ftobler/bldc-controller/README.md

# A bunch of BLDC controller and related PCB

Software for STM32.

PCB in Eagle.
