ftobler/bldc-controller/pcb/pcb-bldc-high-current/pcb-bldc-high-current.pdf

GND ⁺³V³ | +5V | VCC | +3V³
GND | GND | GND | GND ⁺⁵V | +5V | +3V³ ¹⁰⁰n

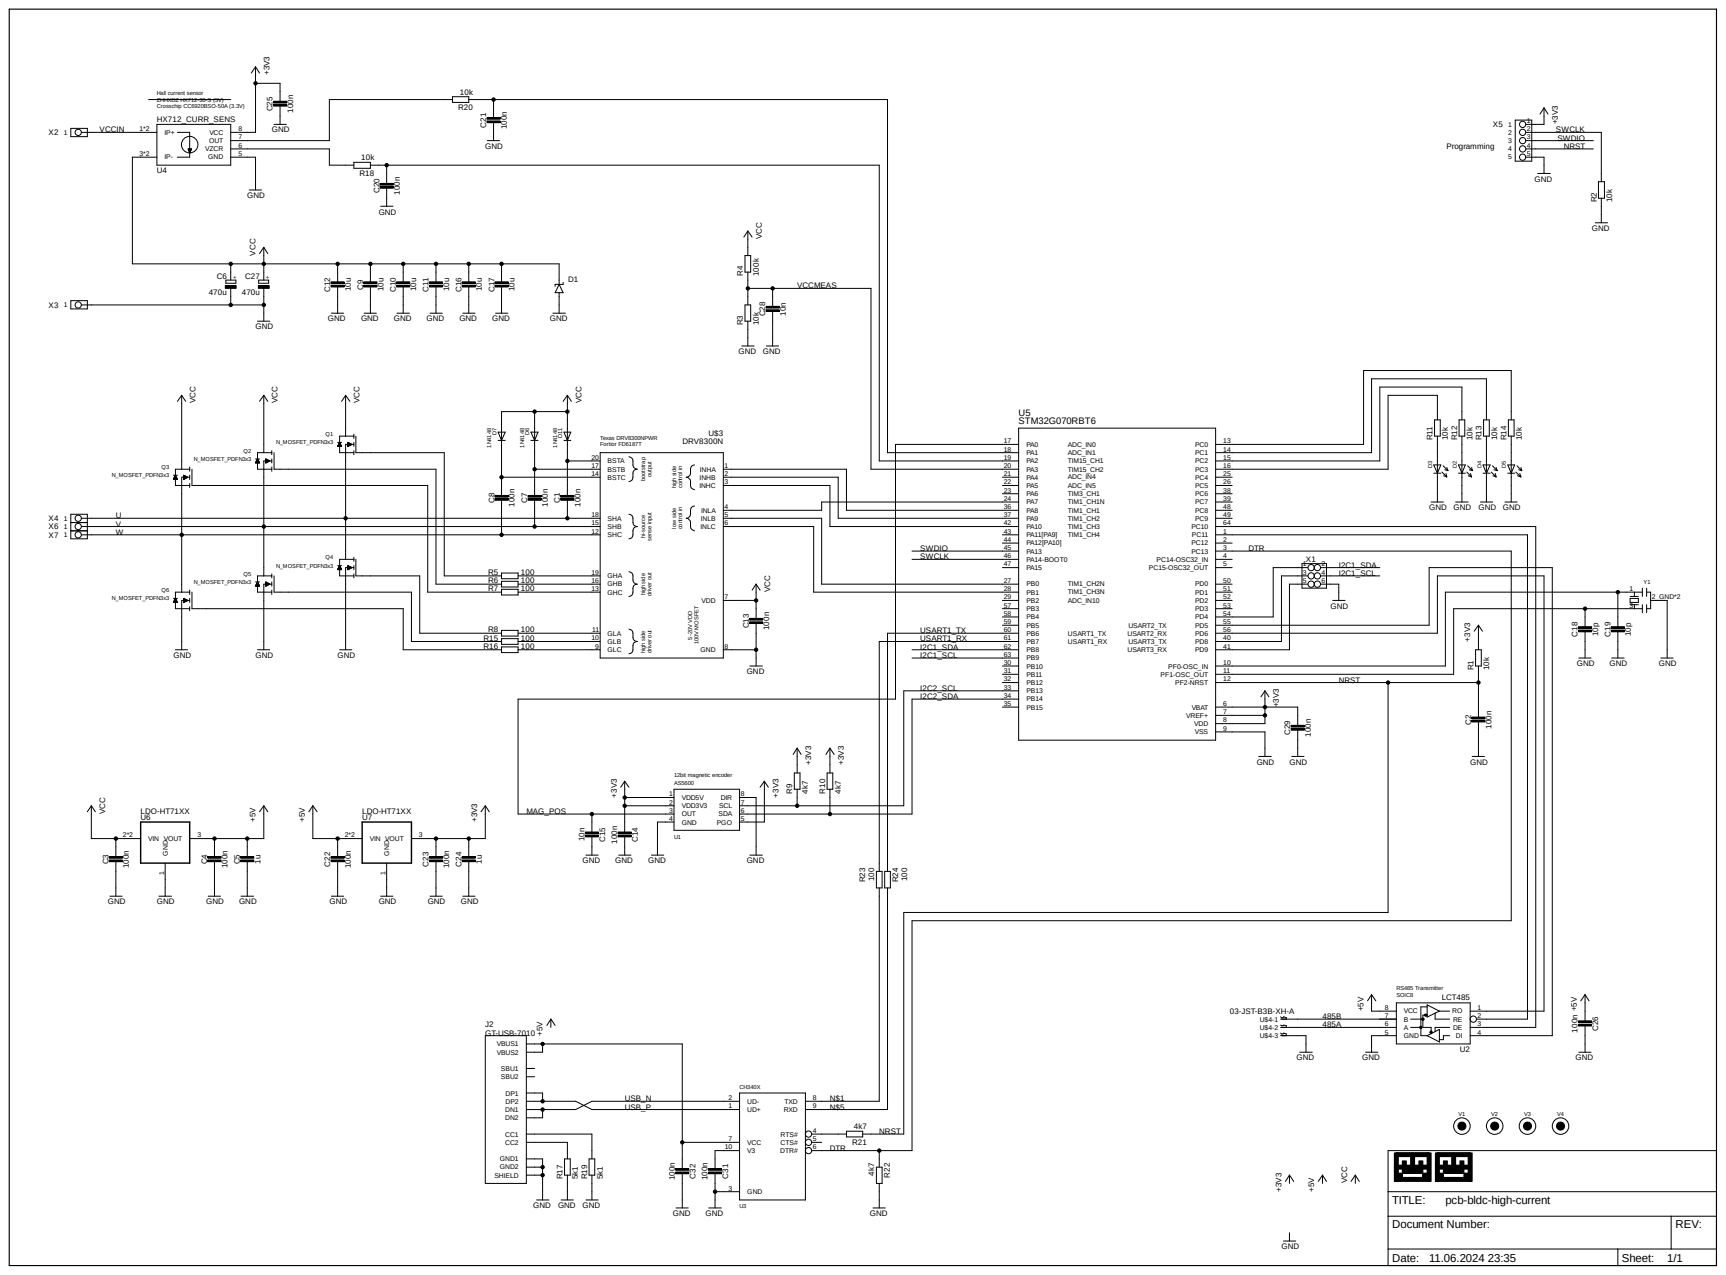
[picture p1: page 1]

GND ¹⁰⁰n GND ⁺³V³

pcb-bldc-high-current

Document Number: | REV:

Date: 11.06.2024 23:35 | Sheet: 1/1
