ftobler/bldc-controller/pcb/pcb-bldc-sensorless2/pcb-bldc-sensorless2.pdf

U2

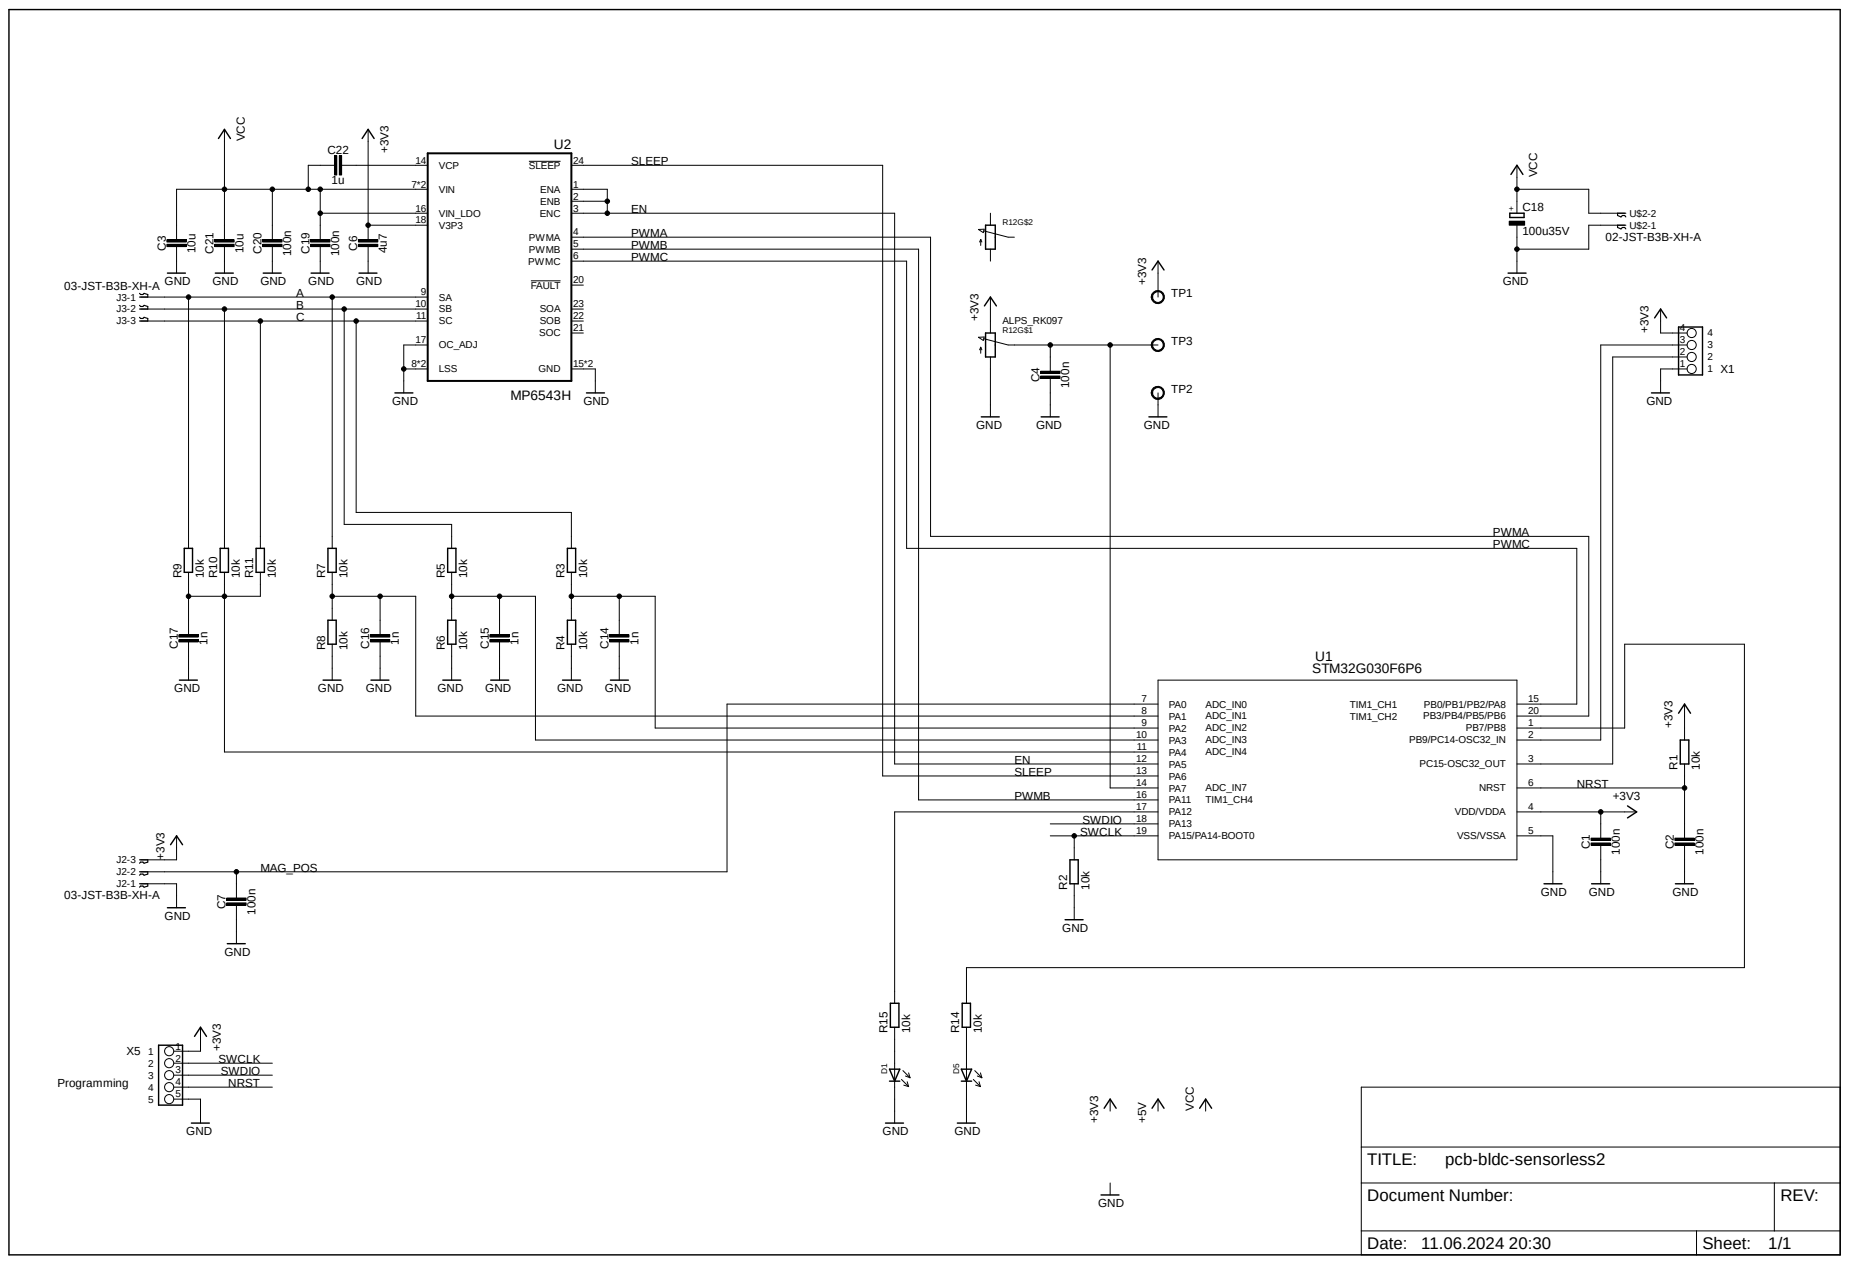
[picture p2: page 1]
GND ⁺³V³; VCC; STM32G030F6P6; GND; GND +3V³; 03-JST-B3B-XH-A ⁺³V³ GND; GND GND; GND ¹⁰k; GND¹⁰k; MP6543H GND; 03-JST-B3B-XH-A; GND ¹⁰u; +3V³ GND; PA6 13 PA7 14 PA11 16 PA12 17 PA13 18 PA15/PA14-BOOT0 19; PB9/PC14-OSC32_IN; PC15-OSC32_OUT; NRST; VDD/VDDA; VSS/VSSA; C¹⁴ R⁵ R⁶; C¹⁵ R⁷ R⁸; C¹⁶ R⁹; R¹⁰; R¹¹ C¹⁷; R¹⁵; R¹⁴; SLEEP; ENA; ENB; ENC; PWMA; PWMB; PWMC; FAULT; SOA; SOB; SOC; VCP 14; VIN 7*2; VIN_LDO 16 V3P3 18; LSS 8*2; OC_ADJ 17; C²¹; C²⁰; C¹⁹; SWDIO; SWCLK; MAG_POS; TITLE: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

02-JST-B3B-XH-A VCC

Document Number: | REV:

Date: 11.06.2024 20:30 | Sheet: 1/1
