ftobler/bldc-controller/pcb/pcb-bldc-high-current/pcb-bldc-high-current.brd

## EAGLE design pcb/pcb-bldc-high-current/pcb-bldc-high-current.brd (2024-06-11)

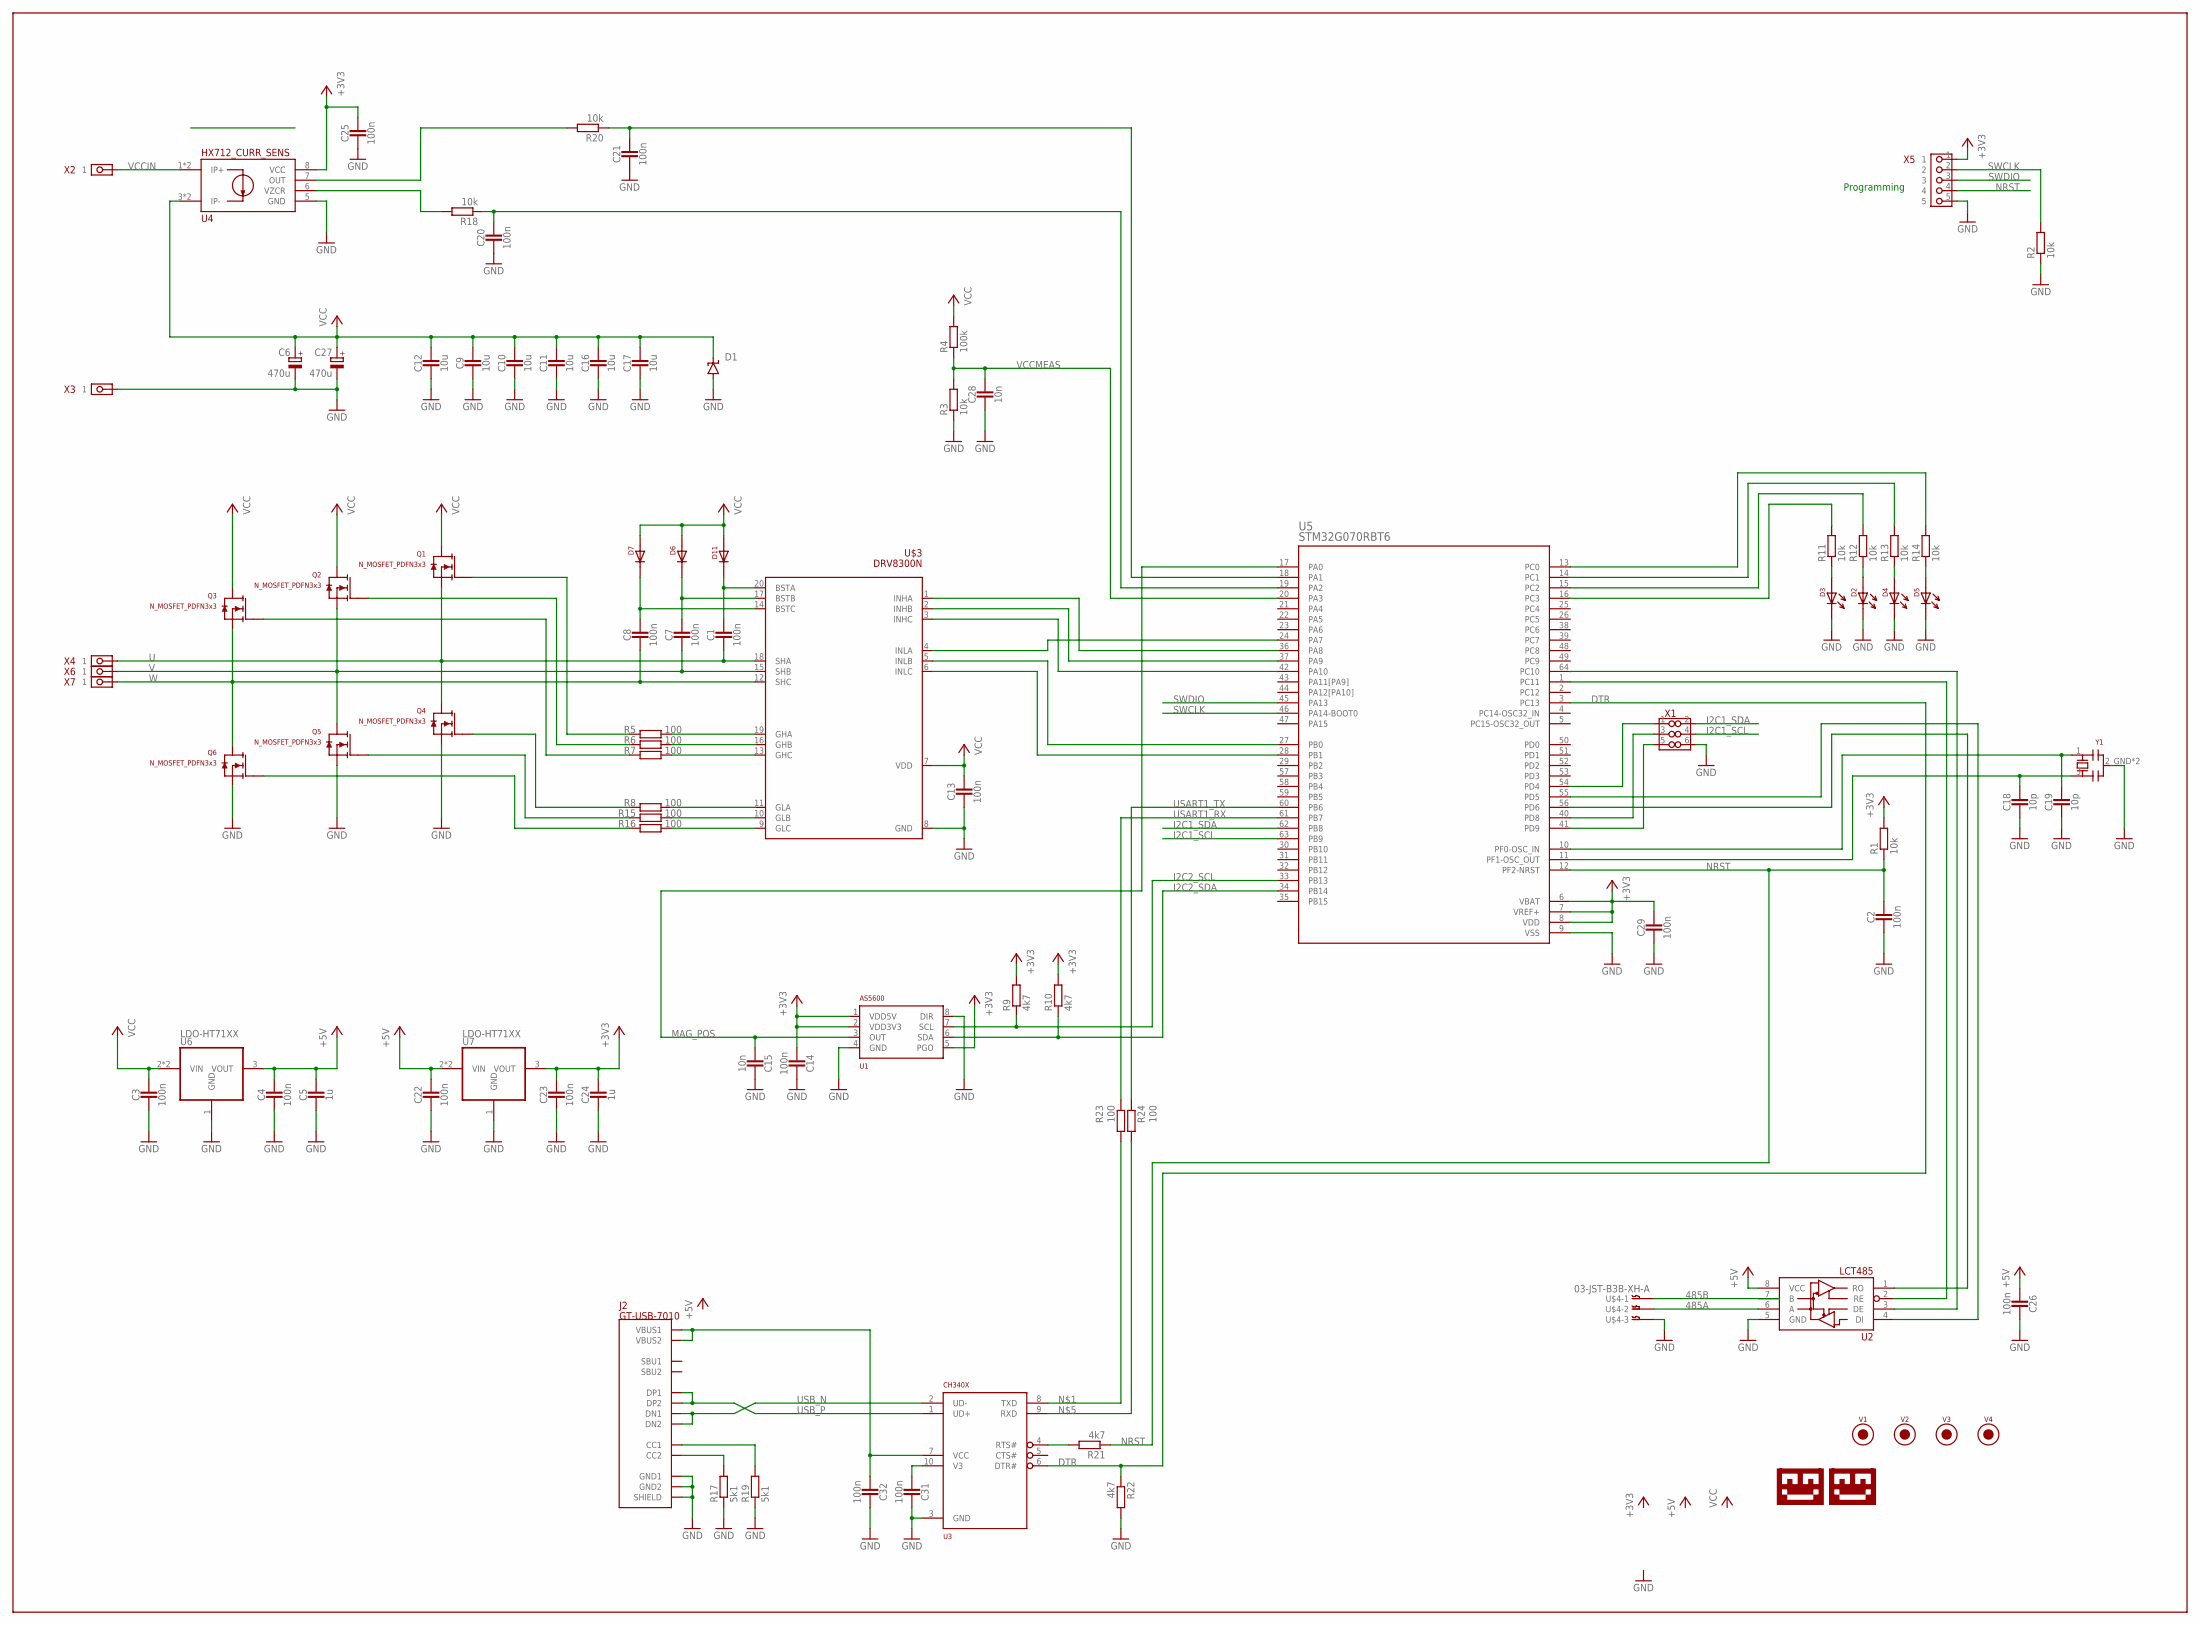
[picture p3: schematic pcb-bldc-high-current.sch]

Parts:
C1, C2, C3, C4, C7, C8, C13, C14, C20, C21, C22, C23, C25, C26, C29, C31, C32: 100n; 0603_CAP
C5, C24: 1u; 0603_CAP
C6, C27: 470u; 153CLV-1010
C9, C10, C11, C12, C16, C17: 10u; 1206_CAP
C15, C28: 10n; 0603_CAP
C18, C19: 10p; 0603_CAP
D1: SUPPRESSOR-SMBJ; SMBJ
D2, D3, D4, D5: LED-0805; 0805-DOT
D6, D7, D11: DIODESOD123; SOD123
J2: GT-USB-7010
Q1, Q2, Q3, Q4, Q5, Q6: N_MOSFET_PDFN3x3; DFN3X3-8L
R1, R2, R3, R11, R12, R13, R14, R18, R20: 10k; 0603-RES
R4: 100k; 0603-RES
R5, R6, R7, R8, R15, R16, R23, R24: 100; 0603-RES
R9, R10, R21, R22: 4k7; 0603-RES
R17, R19: 5k1; 0603-RES
U1: AS5600; SOIC-8
U2: LCT485_BUS_TRANSCEIVER; SOIC-8
U3: CH340X; MSOP-10
U4: HX712_CURR_SENS; SOIC-8
U5: STM32G070RBT6; LQFP-64
U6, U7: LDO-HT71XX; SOT-89
U$1: LOGO-TOBENG-1MM-FINISH; TOBENG-1MM-FINISH
U$2: LOGO-0.25MM
U$3: DRV8300N; TSSOP20
U$4: 03-JST-B3B-XH-A; B3B-XH
V1, V2, V3, V4: FIDUCIAL2MM; FIDUCIAL_2MM
X1: PIN_3X2HD; PIN_3X2_HD
X2, X3: PIN_1X1WELDINGTERMINAL; XFCNTS34031
X4, X6, X7: PIN_1X1WIRE1; PIN_1X1_SOLDERWIRE_1
X5: PIN_5X1HD; PIN_5X1_HD
Y1: 3213-QUARZ3225; 3225-QUARZ

Connections:
485A: U2.6 (A), U$4.P$2
485B: U2.7 (B), U$4.P$1
+3V3: C14.1, C23.1, C24.1, C25.1, C29.1, R1.2, R9.2, R10.2, U1.1 (VDD5V), U1.2 (VDD3V3), U1.5 (PGO), U4.8 (VCC), U5.6 (VBAT), U5.7 (VREF+), U5.8 (VDD), U7.3 (VOUT), X5.1
+5V: C4.1, C5.1, C22.1, C26.1, U2.8 (VCC), U6.3 (VOUT), U7.2 (VIN), U7.2@1 (VIN)
DTR: R22.1, U3.6 (DTR#), U5.3 (PC13)
GND: C2.2, C3.2, C4.2, C5.2, C6.-, C9.2, C10.2, C11.2, C12.2, C13.2, C14.2, C15.2, C16.2, C17.2, C18.2, C19.2, C20.2, C21.2, C22.2, C23.2, C24.2, C25.2, C26.2, C27.-, C28.2, C29.2, C31.2, C32.2, D1.A, D2.2, D3.2, D4.2, D5.2, J2.13 (SHIELD), J2.14 (SHIELD), J2.15 (SHIELD), J2.16 (SHIELD), J2.A1B12 (GND1), J2.B1A12 (GND2), J2.PAD1 (SHIELD), J2.PAD2 (SHIELD), J2.PAD3 (SHIELD), J2.PAD4 (SHIELD), J2.PAD5 (SHIELD), J2.PAD6 (SHIELD), Q4.S1 (S), Q4.S2 (S), Q4.S3 (S), Q5.S1 (S), Q5.S2 (S), Q5.S3 (S), Q6.S1 (S), Q6.S2 (S), Q6.S3 (S), R2.1, R3.1, R17.1, R19.1, R22.2, U1.4 (GND), U1.8 (DIR), U2.5 (GND), U3.3 (GND), U4.5 (GND), U5.9 (VSS), U6.1 (GND), U7.1 (GND), U$3.8 (GND), U$4.P$3, X1.6, X3.1, X3.2, X3.3, X3.4, X5.5, Y1.2_GND (2), Y1.4_GND (2)
I2C1_SCL: U5.63 (PB9), X1.4
I2C1_SDA: U5.62 (PB8), X1.2
I2C2_SCL: R9.1, U1.7 (SCL), U5.33 (PB13)
I2C2_SDA: R10.1, U1.6 (SDA), U5.34 (PB14)
MAG_POS: C15.1, U1.3 (OUT), U5.17 (PA0)
unnamed: R23.2, U3.8 (TXD)
unnamed: C18.1, U5.11 (PF1-OSC_OUT), Y1.3
unnamed: C19.1, U5.10 (PF0-OSC_IN), Y1.1
unnamed: C1.1, D11.C (2), U$3.20 (BSTA)
unnamed: R24.2, U3.9 (RXD)
unnamed: C7.1, D6.C (2), U$3.17 (BSTB)
unnamed: C8.1, D7.C (2), U$3.14 (BSTC)
unnamed: D3.1, R11.1
unnamed: U5.41 (PD9), X1.5
unnamed: Q4.G, R8.2
unnamed: Q5.G, R15.2
unnamed: Q6.G, R16.2
unnamed: Q1.G, R5.2
unnamed: Q2.G, R6.2
unnamed: Q3.G, R7.2
unnamed: D2.1, R12.1
unnamed: D4.1, R13.1
unnamed: D5.1, R14.1
unnamed: R14.2, U5.13 (PC0)
unnamed: R13.2, U5.14 (PC1)
unnamed: R12.2, U5.15 (PC2)
unnamed: R11.2, U5.16 (PC3)
unnamed: U5.36 (PA8), U$3.1 (INHA)
unnamed: U5.24 (PA7), U$3.4 (INLA)
unnamed: U5.37 (PA9), U$3.2 (INHB)
unnamed: U5.27 (PB0), U$3.5 (INLB)
unnamed: U5.42 (PA10), U$3.3 (INHC)
unnamed: U5.28 (PB1), U$3.6 (INLC)
unnamed: R5.1, U$3.19 (GHA)
unnamed: R6.1, U$3.16 (GHB)
unnamed: R7.1, U$3.13 (GHC)
unnamed: R8.1, U$3.11 (GLA)
unnamed: R15.1, U$3.10 (GLB)
unnamed: R16.1, U$3.9 (GLC)
unnamed: C32.1, J2.A4B9 (VBUS1), J2.B4A9 (VBUS2), U3.7 (VCC)
unnamed: R21.2, U3.4 (RTS#)
unnamed: U5.40 (PD8), X1.3
unnamed: C20.1, R18.1, U5.19 (PA2)
unnamed: C21.1, R20.1, U5.18 (PA1)
unnamed: R18.2, U4.6 (VZCR)
unnamed: R20.2, U4.7 (OUT)
unnamed: U2.1 (RO), U5.56 (PD6)
unnamed: U2.2 (RE), U5.1 (PC11)
unnamed: U2.3 (DE), U5.64 (PC10)
unnamed: U2.4 (DI), U5.55 (PD5)
unnamed: U5.54 (PD4), X1.1
unnamed: J2.B5 (CC2), R17.2
unnamed: J2.A5 (CC1), R19.2
unnamed: C31.1, U3.10 (V3)
NRST: C2.1, R1.1, R21.1, U5.12 (PF2-NRST), X5.4
SWCLK: R2.2, U5.46 (PA14-BOOT0), X5.2
SWDIO: U5.45 (PA13), X5.3
U: C1.2, Q1.S1 (S), Q1.S2 (S), Q1.S3 (S), Q4.D, U$3.18 (SHA), X4.P$1, X4.P$2, X4.P$3, X4.P$4, X4.P$5, X4.P$6, X4.P$7, X4.P$8, X4.P$9, X4.P$10, X4.P$11, X4.P$12, X4.P$13, X4.P$14, X4.P$15, X4.P$16, X4.P$17, X4.P$18, X4.P$19, X4.P$20
USART1_RX: R23.1, U5.61 (PB7)
USART1_TX: R24.1, U5.60 (PB6)
USB_N: J2.A7 (DN1), J2.B7 (DN2), U3.2 (UD-)
USB_P: J2.A6 (DP1), J2.B6 (DP2), U3.1 (UD+)
V: C7.2, Q2.S1 (S), Q2.S2 (S), Q2.S3 (S), Q5.D, U$3.15 (SHB), X6.P$1, X6.P$2, X6.P$3, X6.P$4, X6.P$5, X6.P$6, X6.P$7, X6.P$8, X6.P$9, X6.P$10, X6.P$11, X6.P$12, X6.P$13, X6.P$14, X6.P$15, X6.P$16, X6.P$17, X6.P$18, X6.P$19, X6.P$20
VCC: C3.1, C6.+, C9.1, C10.1, C11.1, C12.1, C13.1, C16.1, C17.1, C27.+, D1.C, D6.A (1), D7.A (1), D11.A (1), Q1.D, Q2.D, Q3.D, R4.2, U4.3 (IP-), U4.4 (IP-), U6.2 (VIN), U6.2@1 (VIN), U$3.7 (VDD)
VCCIN: U4.1 (IP+), U4.2 (IP+), X2.1, X2.2, X2.3, X2.4
VCCMEAS: C28.1, R3.2, R4.1, U5.20 (PA3)
W: C8.2, Q3.S1 (S), Q3.S2 (S), Q3.S3 (S), Q6.D, U$3.12 (SHC), X7.P$1, X7.P$2, X7.P$3, X7.P$4, X7.P$5, X7.P$6, X7.P$7, X7.P$8, X7.P$9, X7.P$10, X7.P$11, X7.P$12, X7.P$13, X7.P$14, X7.P$15, X7.P$16, X7.P$17, X7.P$18, X7.P$19, X7.P$20

Notes on the sheet:
Programming

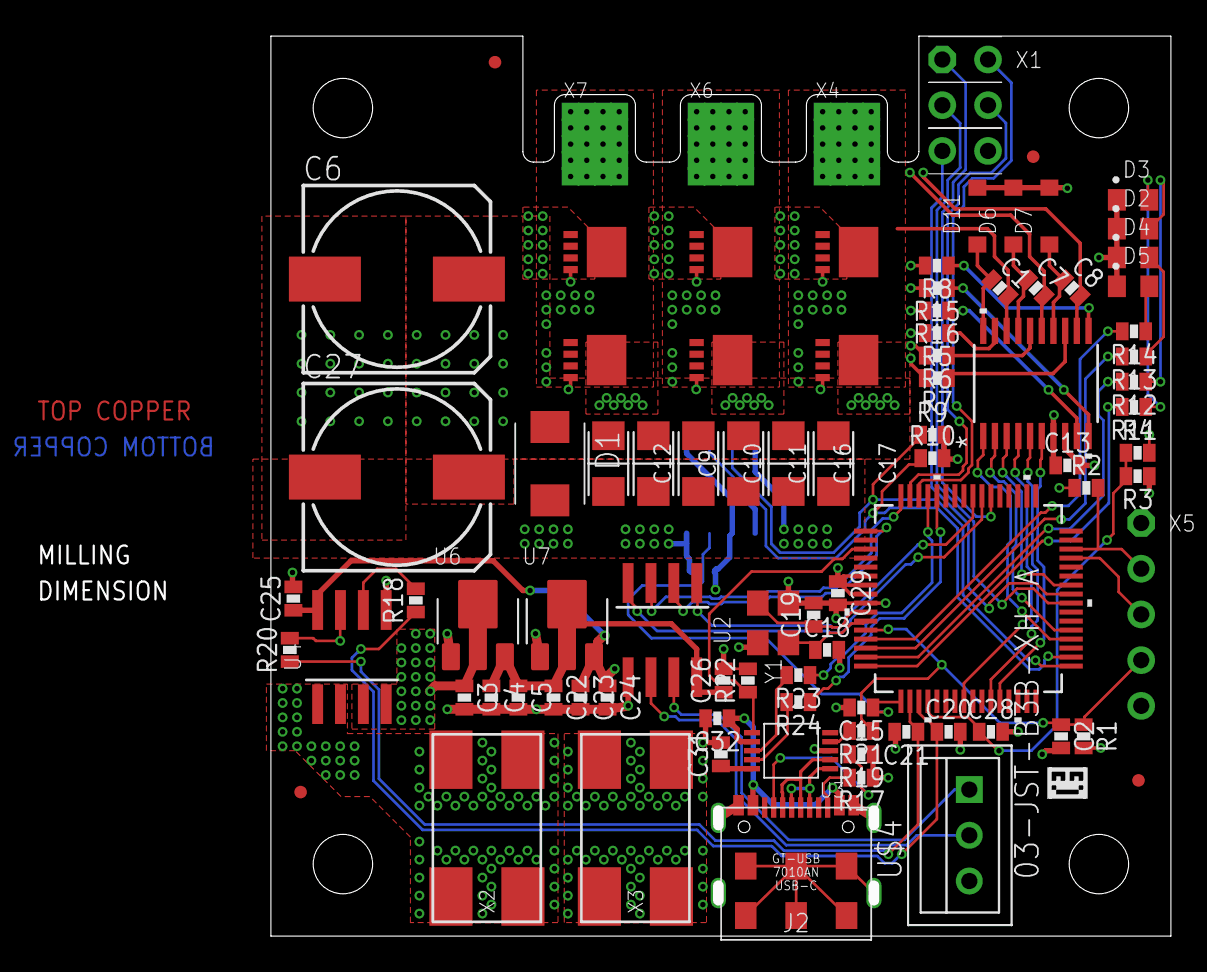
[picture p4: board pcb-bldc-high-current.brd from above]

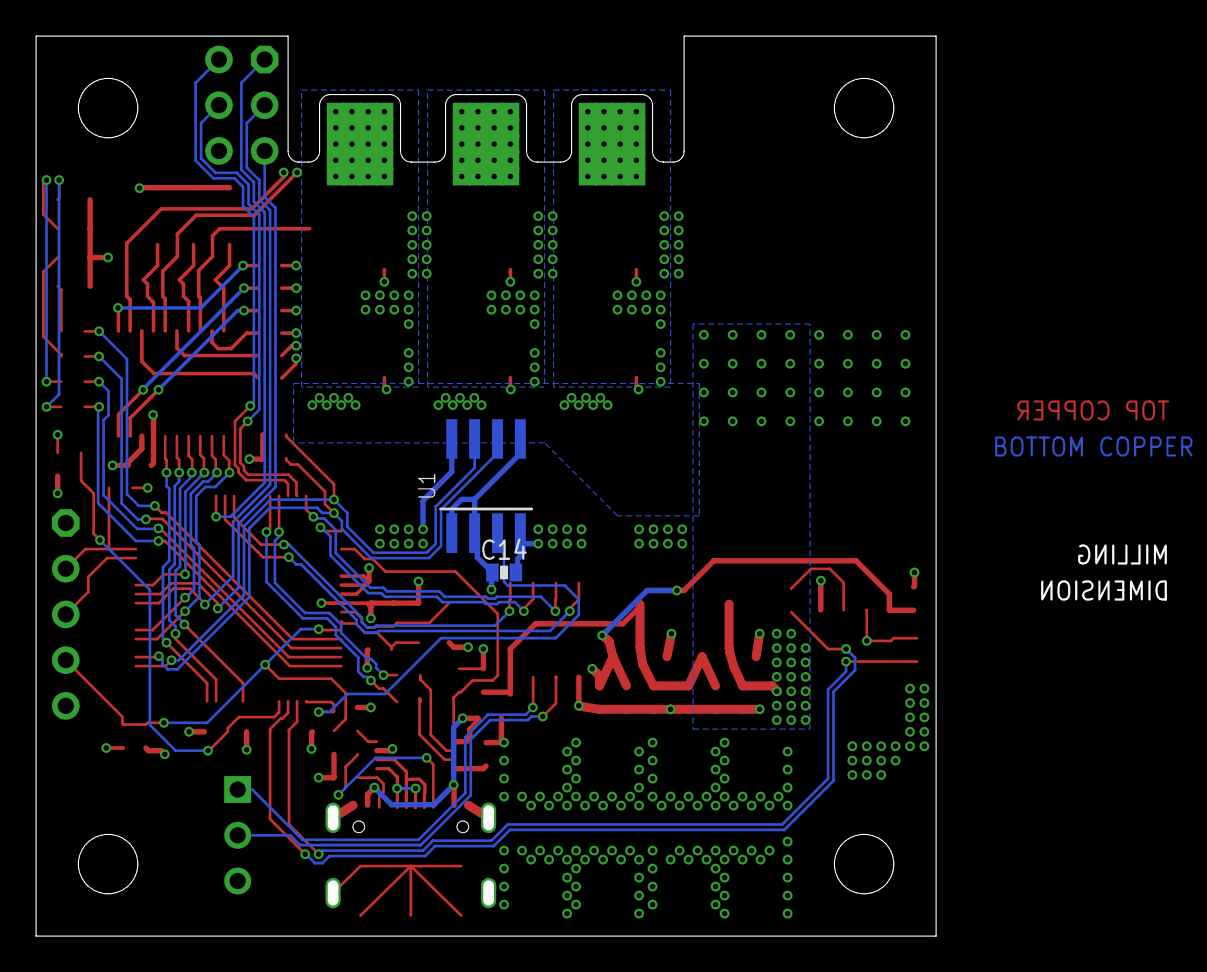
[picture p5: board pcb-bldc-high-current.brd from below]

Board: 4 copper layers, 50.0 x 50.0 mm, 93 parts (3 on the bottom side), 73 nets.
