ftobler/bldc-controller/pcb/pcb-bldc-sensorless2/pcb-bldc-sensorless2.brd

## EAGLE design pcb/pcb-bldc-sensorless2/pcb-bldc-sensorless2.brd (2024-06-11)

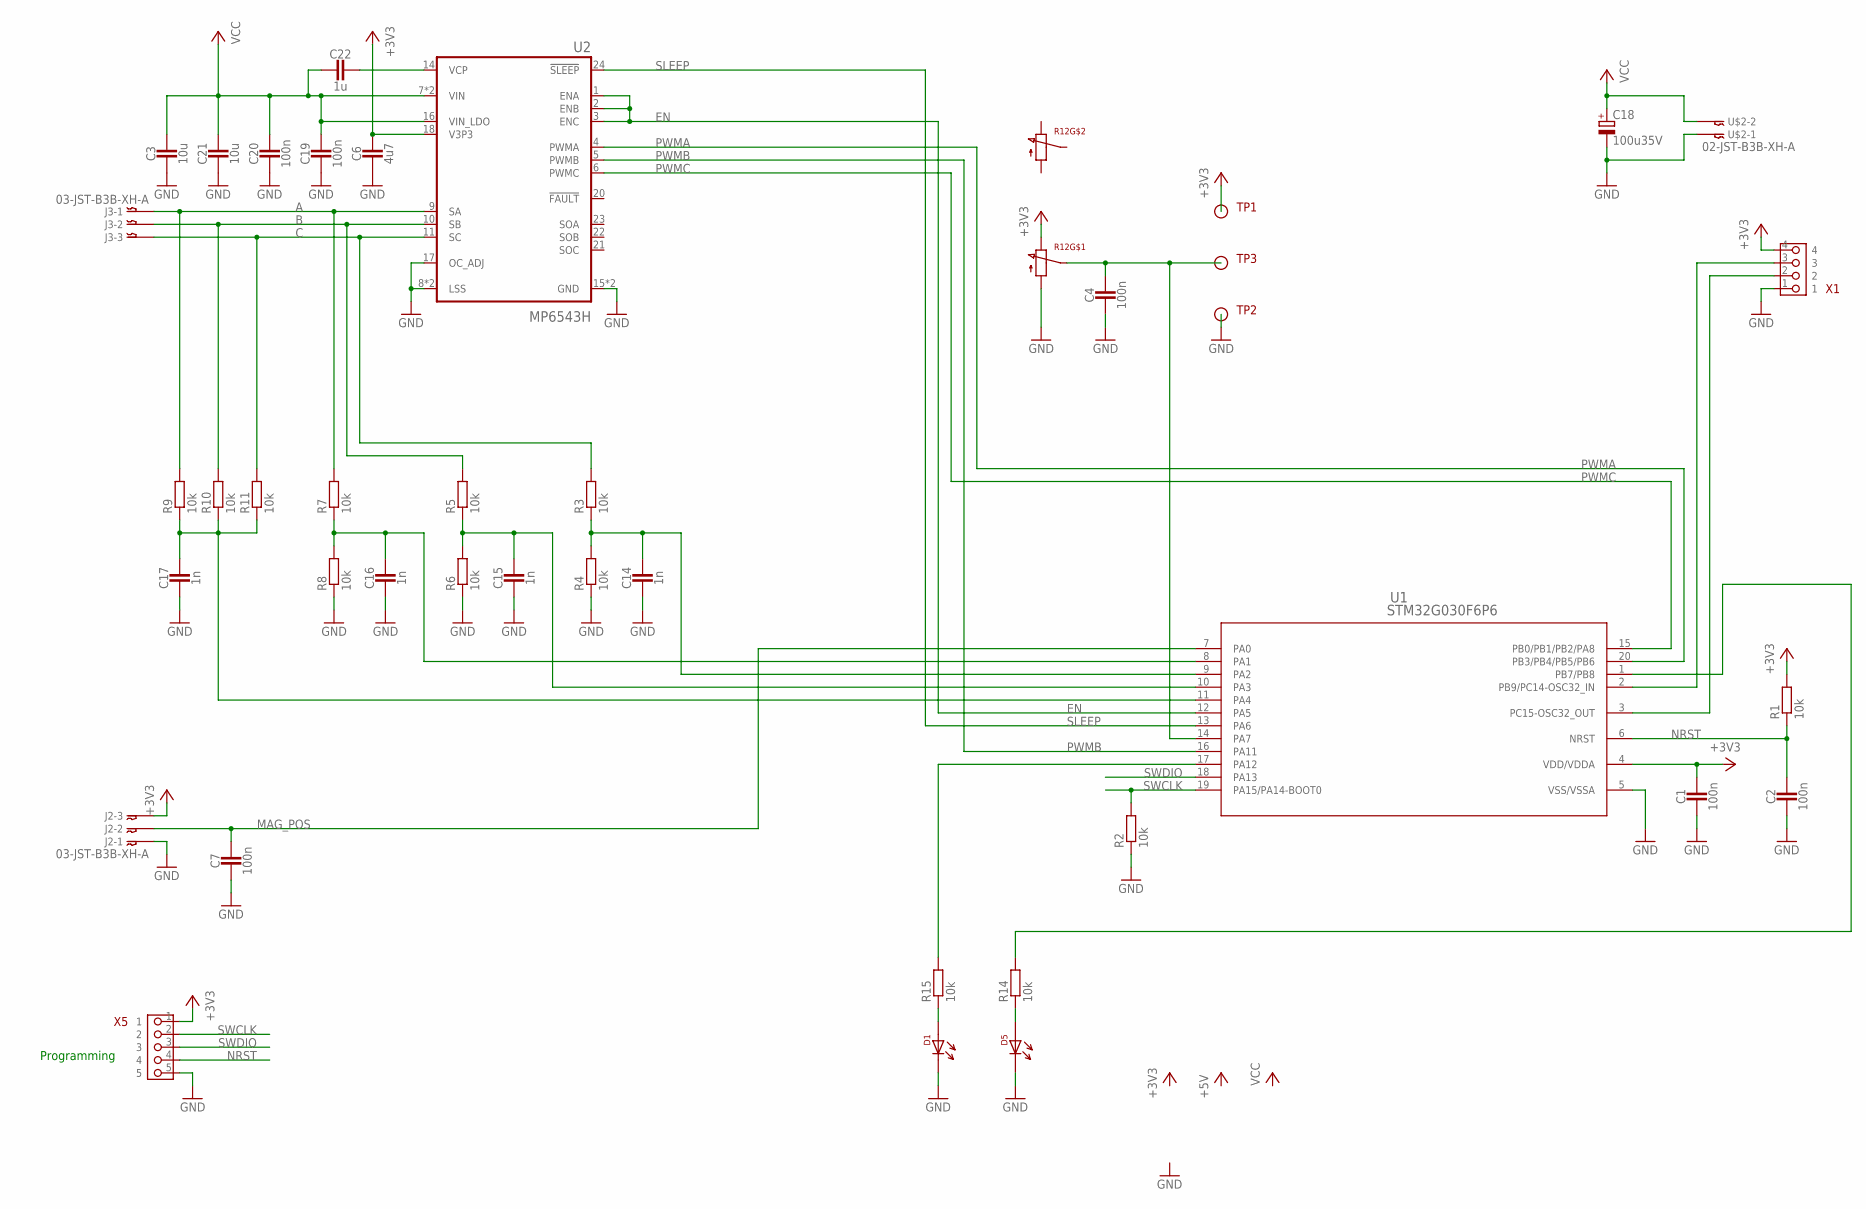
[picture p6: schematic pcb-bldc-sensorless2.sch]

Parts:
C1, C2, C4, C7, C19, C20: 100n; 0603_CAP
C3, C21: 10u; 1206_CAP
C6: 4u7; 0805_CAP
C14, C15, C16, C17: 1n; 0603_CAP
C18: 100u35V; 153CLV-0605
C22: 1u; 0603_CAP
D1, D5: LED-0805; 0805-DOT
J2, J3: 03-JST-B3B-XH-A; B3B-XH
R1, R2, R3, R4, R5, R6, R7, R8, R9, R10, R11, R14, R15: 10k; 0603-RES
R12: POTDUAL; ALPS_RK097
TP1, TP2, TP3: TESTPIN; PIN-SMD-1X1-TEST_1M5
U1: STM32G030F6P6; TSSOP20
U2: MP6543H; QFN24
U$2: 02-JST-B3B-XH-A; B2B-XH
X1: PIN_4X1HD; PIN_4X1_HD
X5: PIN_5X1HD; PIN_5X1_HD

Connections:
+3V3: C1.1, C6.P$1 (1), J2.P$3, R1.2, R12.R11 (1), TP1.1, U1.4 (VDD/VDDA), U2.18 (V3P3), X1.4, X5.1
A: J3.P$1, R7.2, R9.2, U2.9 (SA)
B: J3.P$2, R5.2, R10.2, U2.10 (SB)
C: J3.P$3, R3.2, R11.2, U2.11 (SC)
EN: U1.12 (PA5), U2.1 (ENA), U2.2 (ENB), U2.3 (ENC)
GND: C1.2, C2.2, C3.2, C4.2, C6.P$2 (2), C7.2, C14.2, C15.2, C16.2, C17.2, C18.-, C19.2, C20.2, C21.2, D1.2, D5.2, J2.P$1, R2.1, R4.1, R6.1, R8.1, R12.R13 (3), TP2.1, U1.5 (VSS/VSSA), U2.8 (LSS), U2.12 (LSS), U2.15 (GND), U2.17 (OC_ADJ), U2.25 (GND), U$2.P$1, X1.1, X5.5
MAG_POS: C7.1, J2.P$2, U1.7 (PA0)
unnamed: C4.1, R12.R12 (2), TP3.1, U1.14 (PA7)
unnamed: C14.1, R3.1, R4.2, U1.9 (PA2)
unnamed: C15.1, R5.1, R6.2, U1.10 (PA3)
unnamed: C17.1, R9.1, R10.1, R11.1, U1.11 (PA4)
unnamed: U1.3 (PC15-OSC32_OUT), X1.2
unnamed: D1.1, R15.1
unnamed: C16.1, R7.1, R8.2, U1.8 (PA1)
unnamed: R15.2, U1.17 (PA12)
unnamed: R14.2, U1.1 (PB7/PB8)
unnamed: D5.1, R14.1
unnamed: U1.2 (PB9/PC14-OSC32_IN), X1.3
unnamed: C22.1, U2.14 (VCP)
NRST: C2.1, R1.1, U1.6 (NRST), X5.4
PWMA: U1.20 (PB3/PB4/PB5/PB6), U2.4 (PWMA)
PWMB: U1.16 (PA11), U2.5 (PWMB)
PWMC: U1.15 (PB0/PB1/PB2/PA8), U2.6 (PWMC)
SLEEP: U1.13 (PA6), U2.24 (!SLEEP)
SWCLK: R2.2, U1.19 (PA15/PA14-BOOT0), X5.2
SWDIO: U1.18 (PA13), X5.3
VCC: C3.1, C18.+, C19.1, C20.1, C21.1, C22.2, U2.7 (VIN), U2.13 (VIN), U2.16 (VIN_LDO), U$2.P$2

Notes on the sheet:
Programming

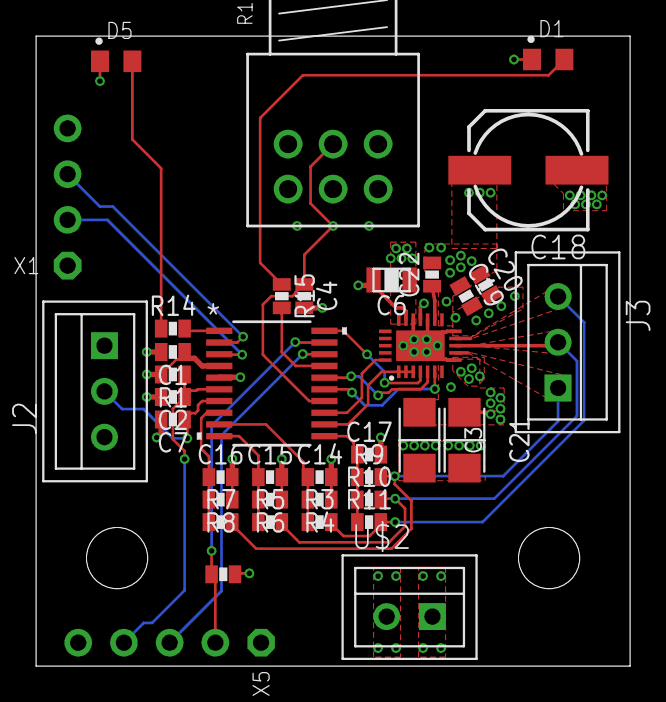
[picture p7: board pcb-bldc-sensorless2.brd from above]

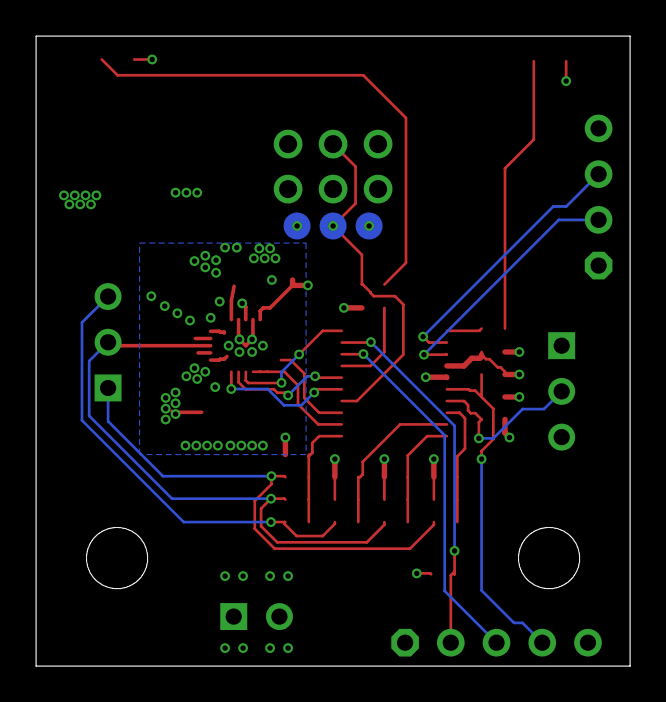
[picture p8: board pcb-bldc-sensorless2.brd from below]

Board: 4 copper layers, 33.0 x 35.0 mm, 41 parts (3 on the bottom side), 27 nets.
