ftobler/bldc-controller/pcb/pcb-bldc-sensorless/pcb-bldc-sensorless.brd

## EAGLE design pcb/pcb-bldc-sensorless/pcb-bldc-sensorless.brd (2024-06-11)

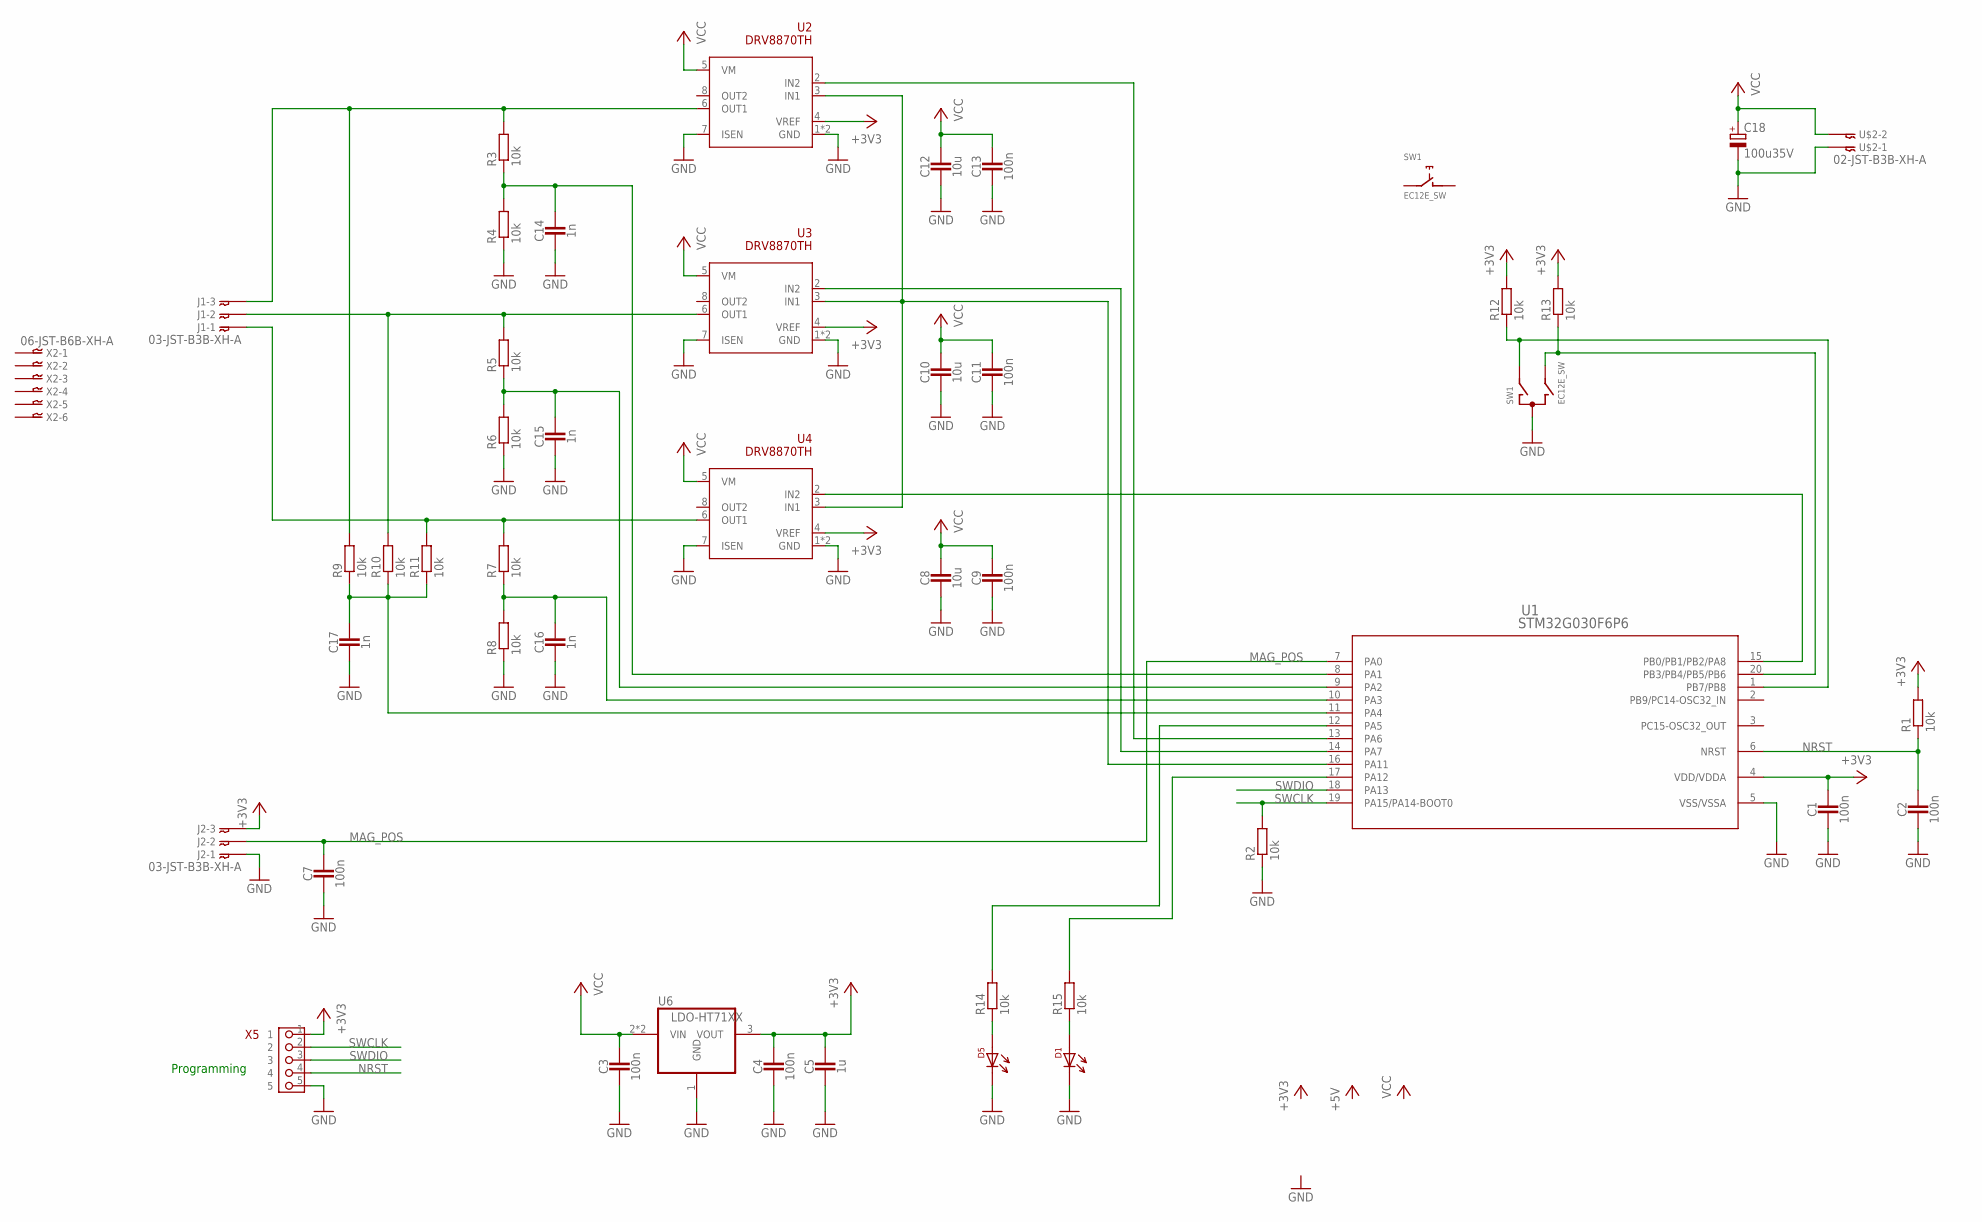
[picture p9: schematic pcb-bldc-sensorless.sch]

Parts:
C1, C2, C3, C4, C7, C9, C11, C13: 100n; 0603_CAP
C5: 1u; 0603_CAP
C8, C10, C12: 10u; 1206_CAP
C14, C15, C16, C17: 1n; 0603_CAP
C18: 100u35V; 153CLV-0605
D1, D5: LED-0805; 0805-DOT
J1, J2: 03-JST-B3B-XH-A; B3B-XH
R1, R2, R3, R4, R5, R6, R7, R8, R9, R10, R11, R12, R13, R14, R15: 10k; 0603-RES
SW1: EC12E_SW; ALPS_EC12E_SW
U1: STM32G030F6P6; TSSOP20
U2, U3, U4: DRV8870TH; SOIC-8-THERM
U6: LDO-HT71XX; SOT-89
U$2: 02-JST-B3B-XH-A; B2B-XH
X2: 06-JST-B6B-XH-A; B6B-XH
X5: PIN_5X1HD; PIN_5X1_HD

Connections:
+3V3: C1.1, C4.1, C5.1, J2.P$3, R1.2, R12.2, R13.2, U1.4 (VDD/VDDA), U2.4 (VREF), U3.4 (VREF), U4.4 (VREF), U6.3 (VOUT), X5.1
GND: C1.2, C2.2, C3.2, C4.2, C5.2, C7.2, C8.2, C9.2, C10.2, C11.2, C12.2, C13.2, C14.2, C15.2, C16.2, C17.2, C18.-, D1.2, D5.2, J2.P$1, R2.1, R4.1, R6.1, R8.1, SW1.C, U1.5 (VSS/VSSA), U2.1 (GND), U2.7 (ISEN), U2.9 (GND), U3.1 (GND), U3.7 (ISEN), U3.9 (GND), U4.1 (GND), U4.7 (ISEN), U4.9 (GND), U6.1 (GND), U$2.P$1, X5.5
MAG_POS: C7.1, J2.P$2, U1.7 (PA0)
unnamed: U1.16 (PA11), U2.3 (IN1), U3.3 (IN1), U4.3 (IN1)
unnamed: C14.1, R3.1, R4.2, U1.8 (PA1)
unnamed: J1.P$2, R5.2, R10.2, U3.6 (OUT1)
unnamed: J1.P$3, R3.2, R9.2, U2.6 (OUT1)
unnamed: U1.13 (PA6), U2.2 (IN2)
unnamed: U1.14 (PA7), U3.2 (IN2)
unnamed: J1.P$1, R7.2, R11.2, U4.6 (OUT1)
unnamed: C15.1, R5.1, R6.2, U1.9 (PA2)
unnamed: U1.15 (PB0/PB1/PB2/PA8), U4.2 (IN2)
unnamed: C16.1, R7.1, R8.2, U1.10 (PA3)
unnamed: C17.1, R9.1, R10.1, R11.1, U1.11 (PA4)
unnamed: R12.1, SW1.A, U1.1 (PB7/PB8)
unnamed: R13.1, SW1.B, U1.20 (PB3/PB4/PB5/PB6)
unnamed: D1.1, R15.1
unnamed: R14.2, U1.12 (PA5)
unnamed: R15.2, U1.17 (PA12)
unnamed: D5.1, R14.1
NRST: C2.1, R1.1, U1.6 (NRST), X5.4
SWCLK: R2.2, U1.19 (PA15/PA14-BOOT0), X5.2
SWDIO: U1.18 (PA13), X5.3
VCC: C3.1, C8.1, C9.1, C10.1, C11.1, C12.1, C13.1, C18.+, U2.5 (VM), U3.5 (VM), U4.5 (VM), U6.2 (VIN), U6.2@1 (VIN), U$2.P$2

Notes on the sheet:
Programming

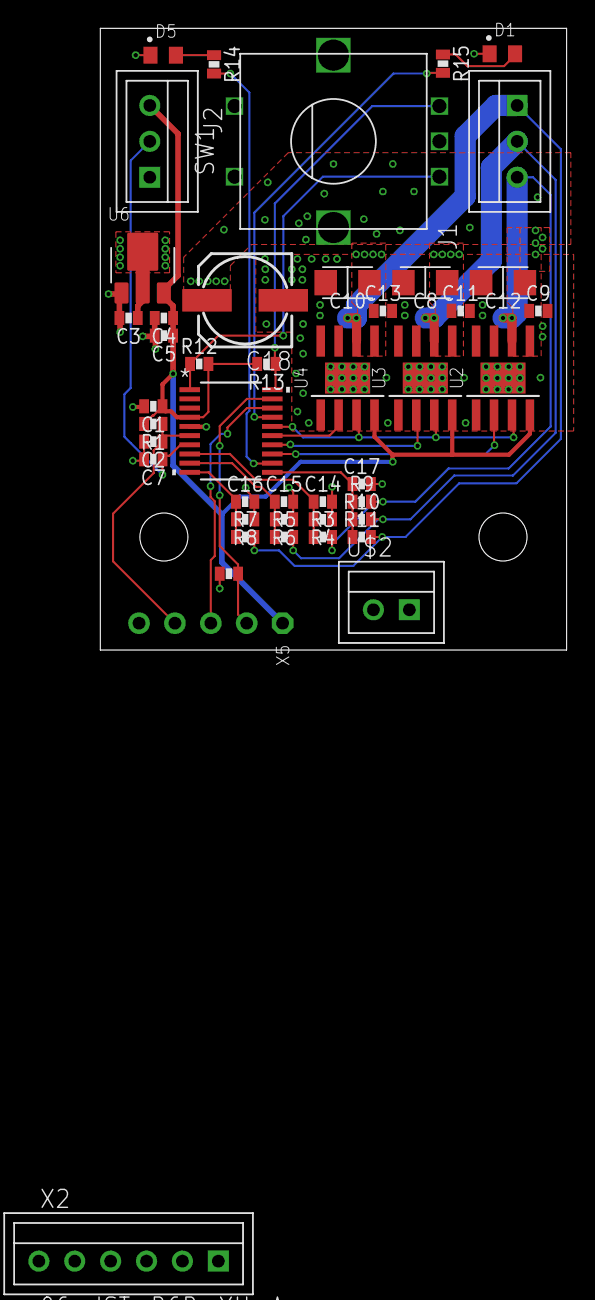
[picture p10: board pcb-bldc-sensorless.brd from above]

Board: 4 copper layers, 33.0 x 44.0 mm, 45 parts (0 on the bottom side), 24 nets.
