ftobler/bldc-controller/pcb/dc-motor-driver/dc-motor-driver.brd

## EAGLE design pcb/dc-motor-driver/dc-motor-driver.brd (2024-05-10)

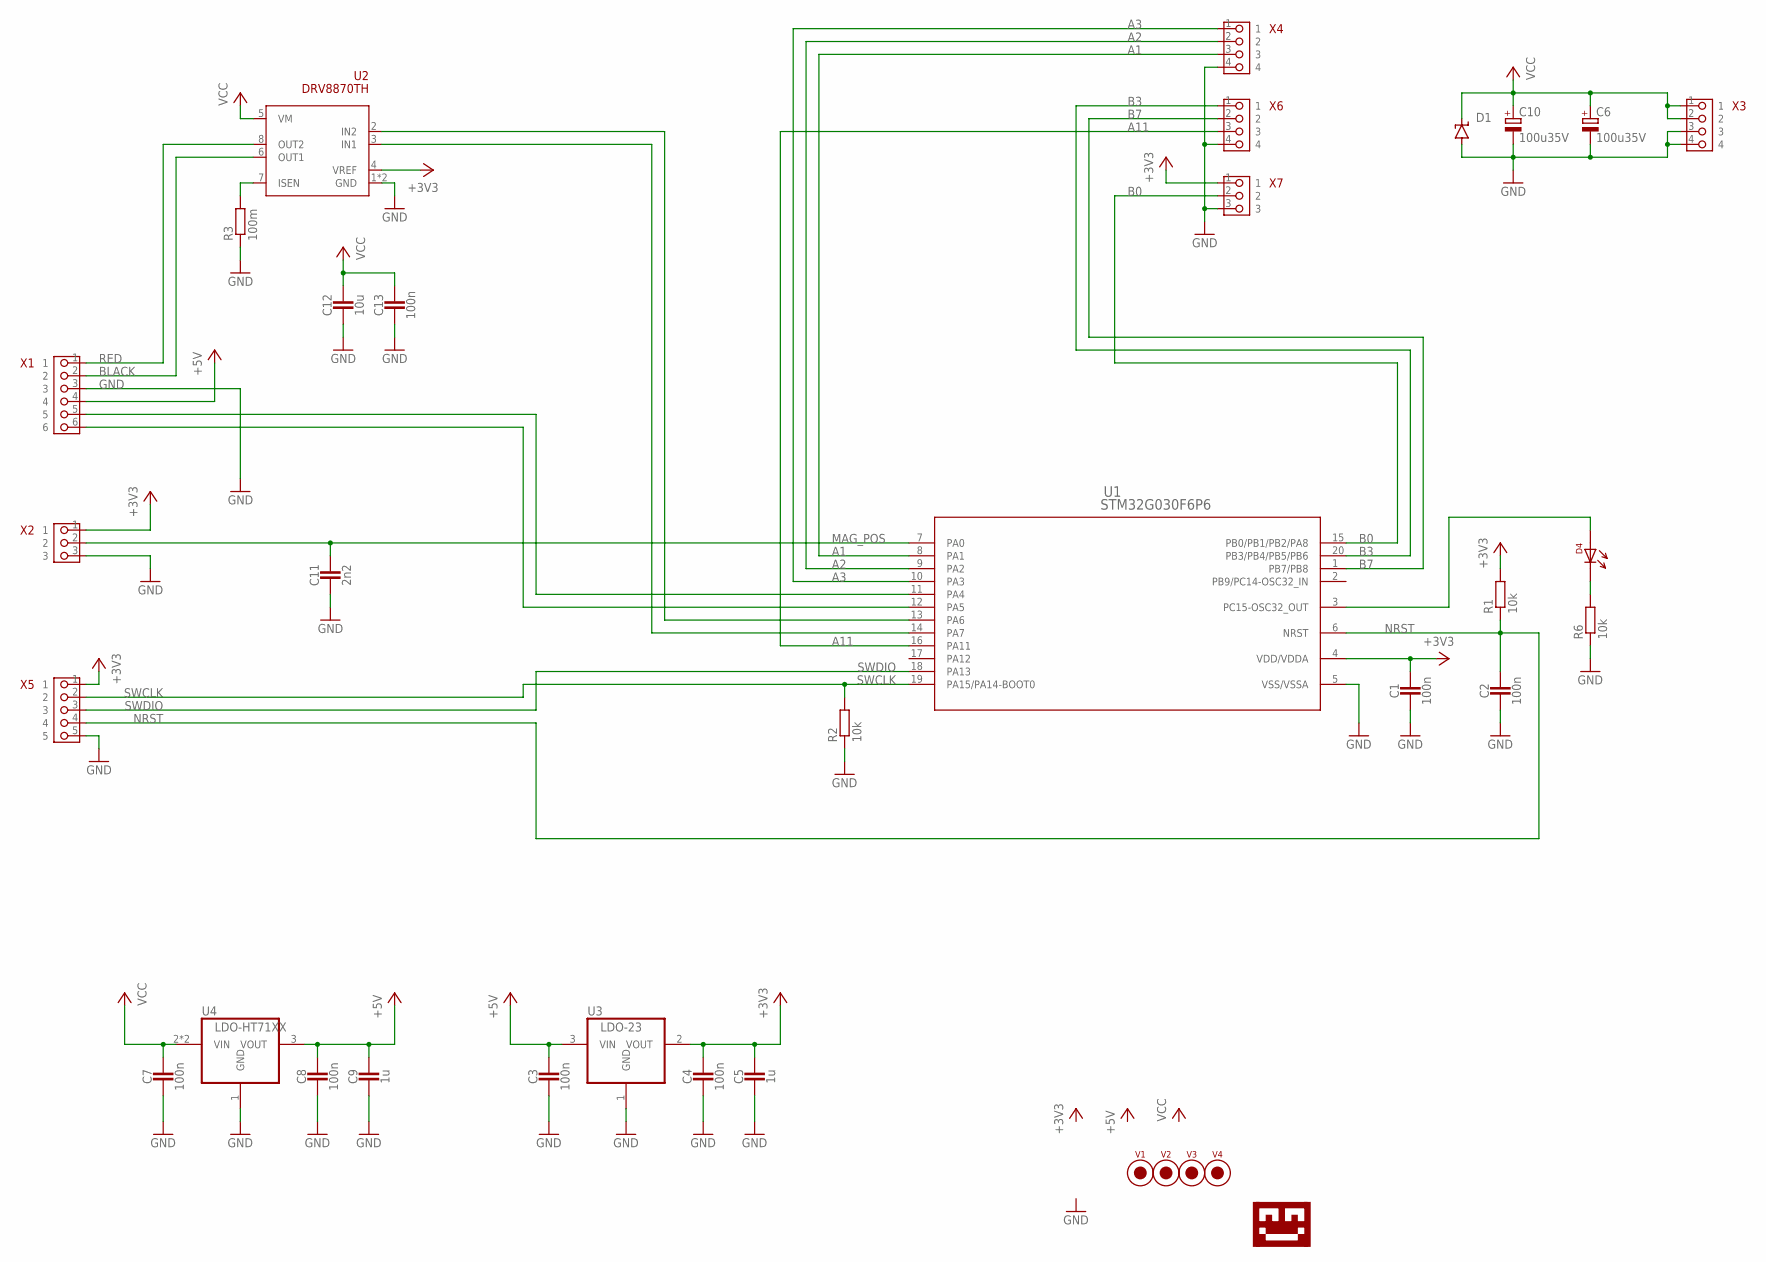
[picture p11: schematic dc-motor-driver.sch]

Parts:
C1, C2, C3, C4, C7, C8, C13: 100n; 0603_CAP
C5, C9: 1u; 0603_CAP
C6, C10: 100u35V; 153CLV-0605
C11: 2n2; 0603_CAP
C12: 10u; 1206_CAP
D1: SUPPRESSOR-SMBJ; SMBJ
D4: LED-0805; 0805-DOT
R1, R2, R6: 10k; 0603-RES
R3: 100m; 1206_RES_HIGH_CLEARANCE
U1: STM32G030F6P6; TSSOP20
U2: DRV8870TH; SOIC-8-THERM
U3: LDO-23; SOT-23
U4: LDO-HT71XX; SOT-89
U$1: LOGO-TOBENG-4MM-FINISH; TOBENG-4MM-FINISH
V1, V2, V3, V4: FIDUCIAL2MM; FIDUCIAL_2MM
X1: PIN_6X1HD; PIN_6X1_HD
X2, X7: PIN_3X1HD; PIN_3X1_HD
X3, X4, X6: PIN_4X1HD; PIN_4X1_HD
X5: PIN_5X1HD; PIN_5X1_HD

Connections:
+3V3: C1.1, C4.1, C5.1, R1.2, U1.4 (VDD/VDDA), U2.4 (VREF), U3.2 (VOUT), X2.1, X5.1, X7.1
+5V: C3.1, C8.1, C9.1, U3.3 (VIN), U4.3 (VOUT), X1.4
A1: U1.8 (PA1), X4.3
A2: U1.9 (PA2), X4.2
A3: U1.10 (PA3), X4.1
A11: U1.16 (PA11), X6.3
B0: U1.15 (PB0/PB1/PB2/PA8), X7.2
B3: U1.20 (PB3/PB4/PB5/PB6), X6.1
B7: U1.1 (PB7/PB8), X6.2
BLACK: U2.6 (OUT1), X1.2
D5: D4.1, U1.3 (PC15-OSC32_OUT)
GND: C1.2, C2.2, C3.2, C4.2, C5.2, C6.-, C7.2, C8.2, C9.2, C10.-, C11.2, C12.2, C13.2, D1.A, R2.1, R3.1, R6.1, U1.5 (VSS/VSSA), U2.1 (GND), U2.9 (GND), U3.1 (GND), U4.1 (GND), X1.3, X2.3, X3.3, X3.4, X4.4, X5.5, X6.4, X7.3
M0U: U1.13 (PA6), U2.2 (IN2)
MAG_POS: C11.1, U1.7 (PA0), X2.2
unnamed: R3.2, U2.7 (ISEN)
unnamed: U1.14 (PA7), U2.3 (IN1)
unnamed: D4.2, R6.2
unnamed: U1.12 (PA5), X1.6
unnamed: U1.11 (PA4), X1.5
NRST: C2.1, R1.1, U1.6 (NRST), X5.4
RED: U2.8 (OUT2), X1.1
SWCLK: R2.2, U1.19 (PA15/PA14-BOOT0), X5.2
SWDIO: U1.18 (PA13), X5.3
VCC: C6.+, C7.1, C10.+, C12.1, C13.1, D1.C, U2.5 (VM), U4.2 (VIN), U4.2@1 (VIN), X3.1, X3.2

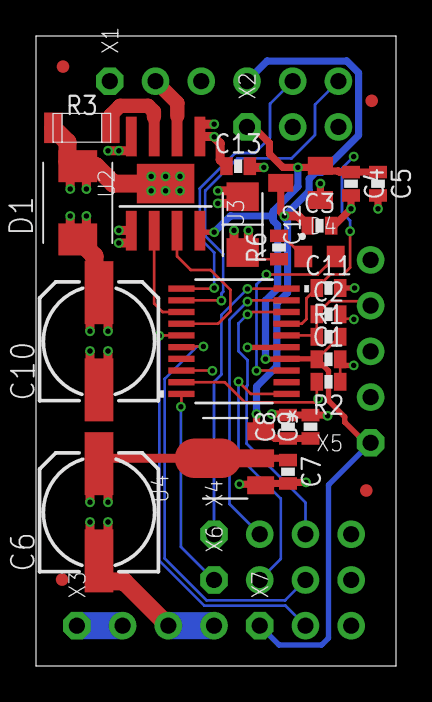
[picture p12: board dc-motor-driver.brd from above]

Board: 4 copper layers, 20.0 x 35.0 mm, 35 parts (1 on the bottom side), 24 nets.
