ftobler/bldc-controller/pcb/pcb-bldc-drive-triple/pcb-bldc-drive-triple.brd

## EAGLE design pcb/pcb-bldc-drive-triple/pcb-bldc-drive-triple.brd (2024-05-10)

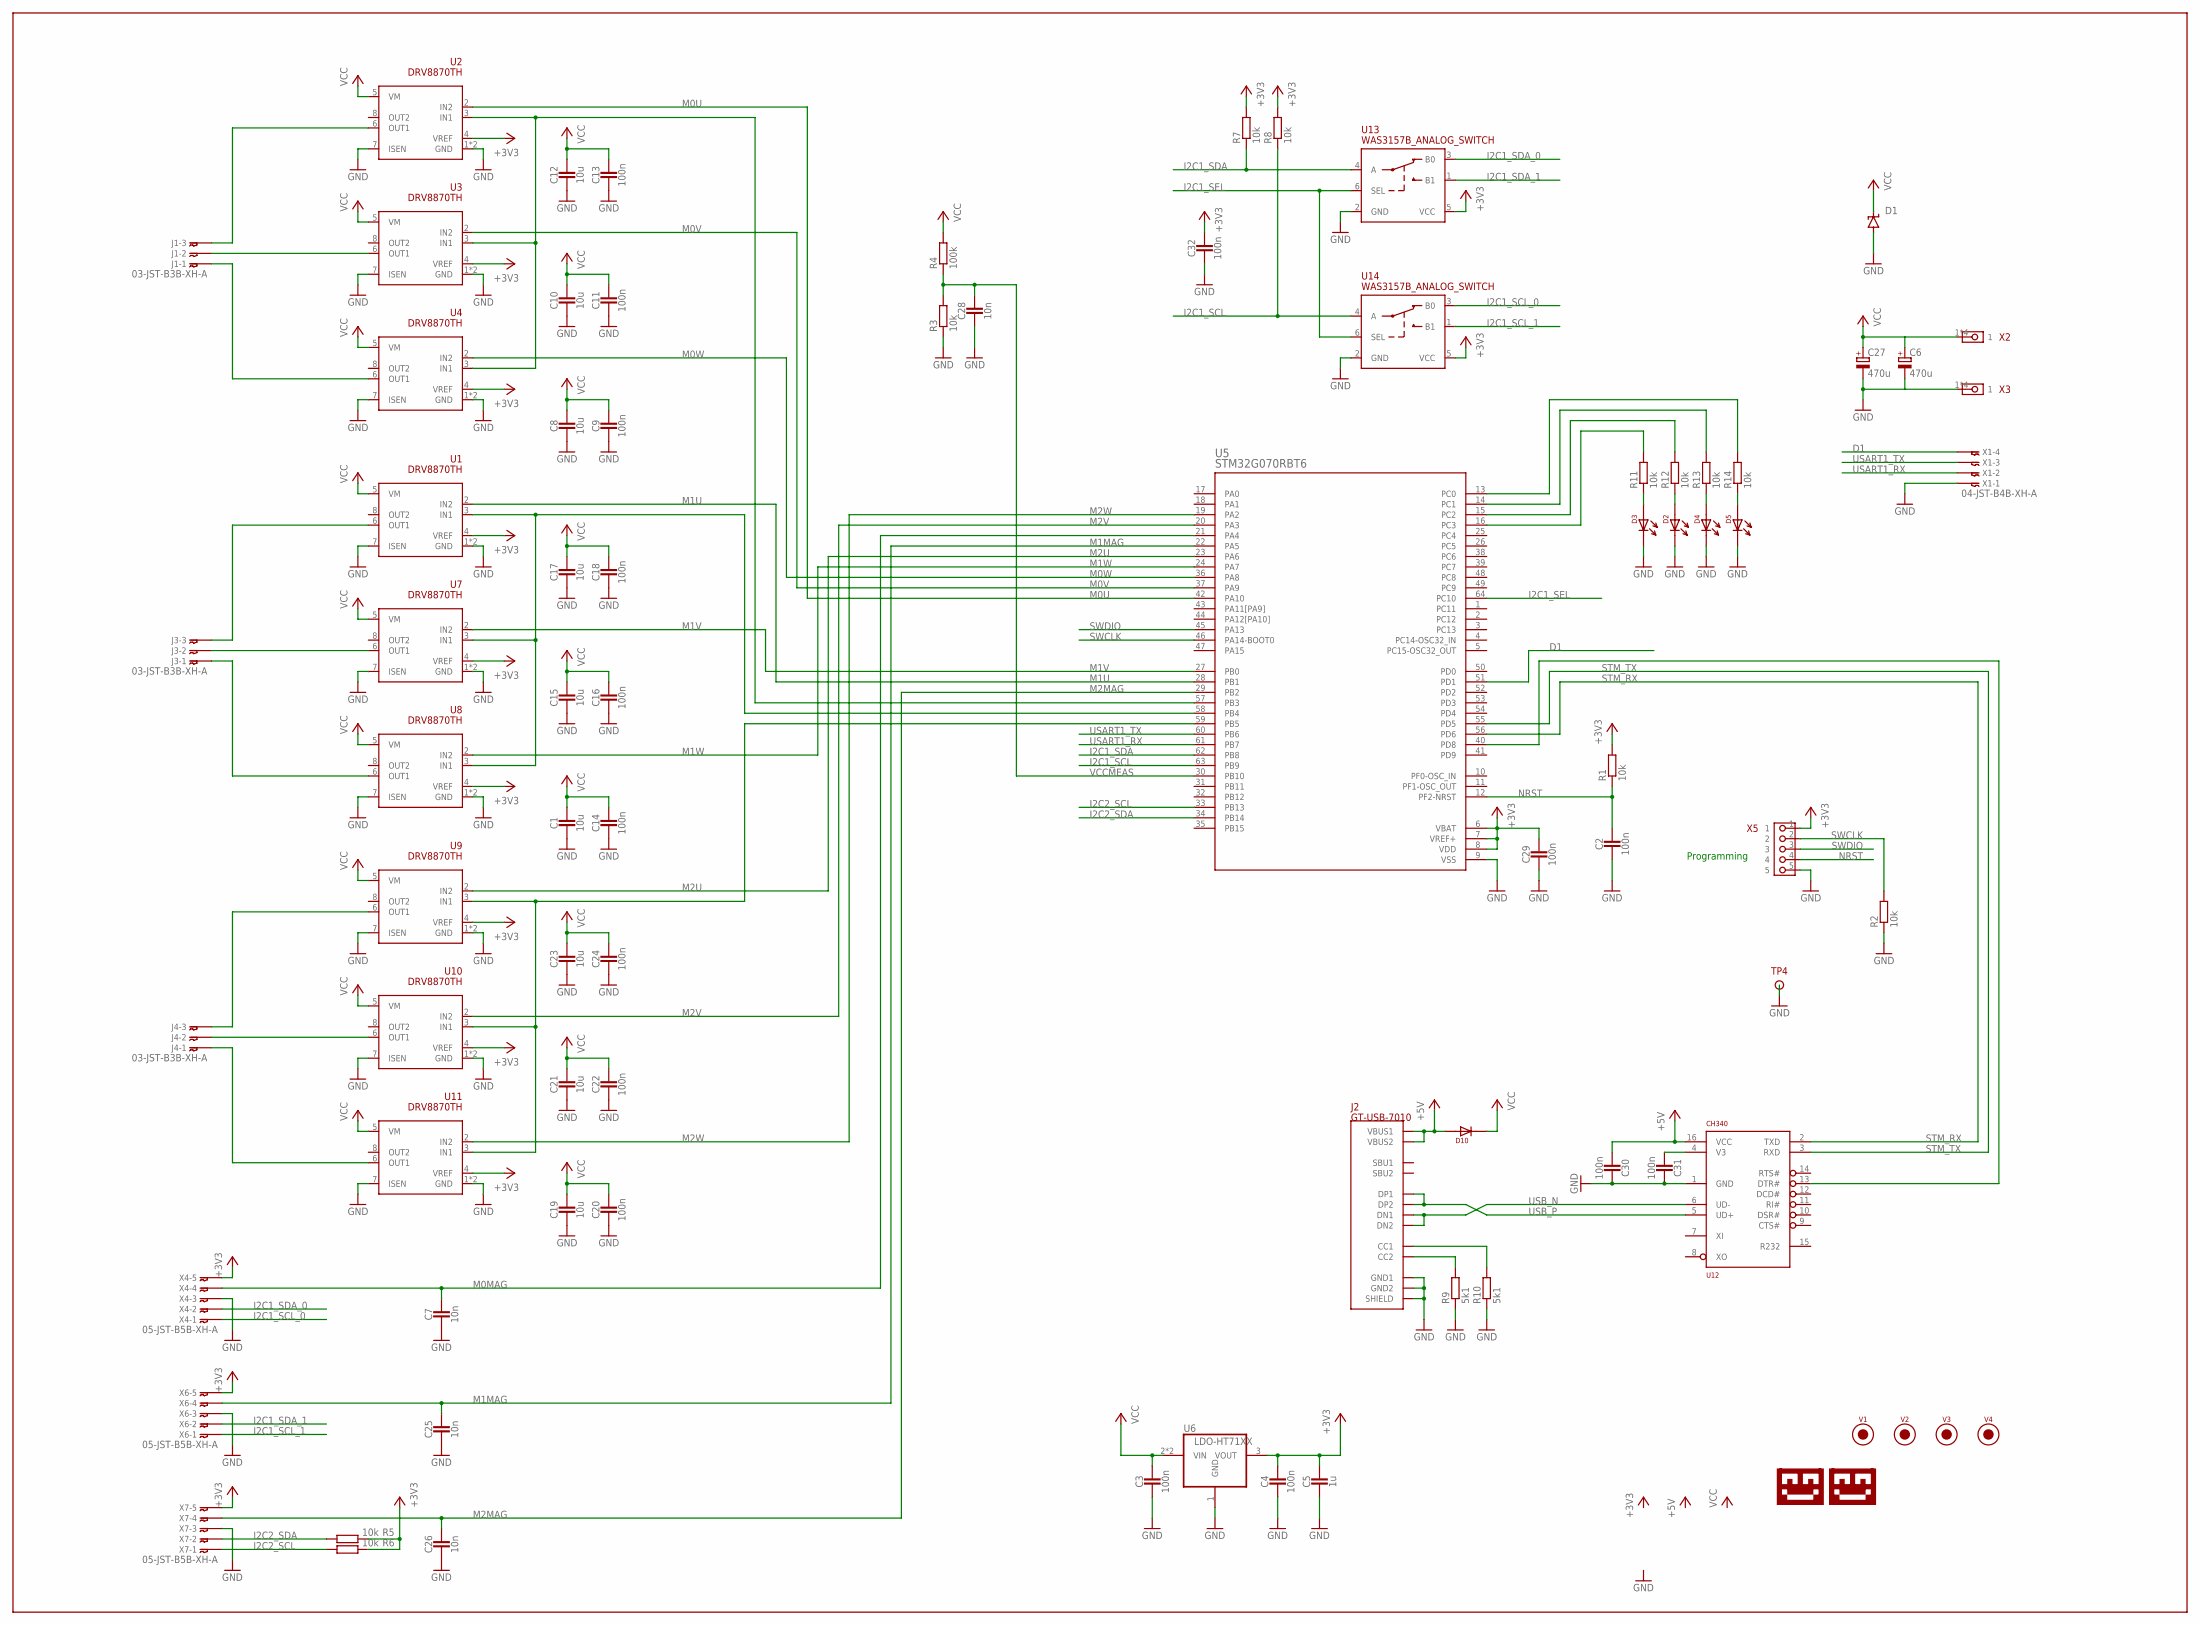
[picture p13: schematic pcb-bldc-drive-triple.sch]

Parts:
C1, C8, C10, C12, C15, C17, C19, C21, C23: 10u; 1206_CAP
C2, C3, C4, C9, C11, C13, C14, C16, C18, C20, C22, C24, C29, C30, C31, C32: 100n; 0603_CAP
C5: 1u; 0603_CAP
C6, C27: 470u; 153CLV-1010
C7, C25, C26, C28: 10n; 0603_CAP
D1: SUPPRESSOR-SMBJ; SMBJ
D2, D3, D4, D5: LED-0805; 0805-DOT
D10: DIODE-1206; 1206-DOT
J1, J3, J4: 03-JST-B3B-XH-A; B3B-XH
J2: GT-USB-7010
R1, R2, R3, R5, R6, R7, R8, R11, R12, R13, R14: 10k; 0603-RES
R4: 100k; 0603-RES
R9, R10: 5k1; 0603-RES
TP4: TESTPIN1MM; PIN-SMD-1X1-TEST_1M0
U1, U2, U3, U4, U7, U8, U9, U10, U11: DRV8870TH; SOIC-8-THERM
U5: STM32G070RBT6; LQFP-64
U6: LDO-HT71XX; SOT-89
U12: CH340; SOIC-16
U13, U14: WAS3157B_ANALOG_SWITCH; SOT323-6
U$1: LOGO-TOBENG-1MM-FINISH; TOBENG-1MM-FINISH
U$2: LOGO-TOBENG-4MM-MASK; TOBENG-4MM-MASK
V1, V2, V3, V4: FIDUCIAL2MM; FIDUCIAL_2MM
X1: 04-JST-B4B-XH-A; B4B-XH
X2, X3: PIN_1X1WELDINGTERMINAL; XFCNTS34031
X4, X6, X7: 05-JST-B5B-XH-A; B5B-XH
X5: PIN_5X1HD; PIN_5X1_HD

Connections:
+3V3: C4.1, C5.1, C29.1, C32.1, R1.2, R5.1, R6.1, R7.2, R8.2, U1.4 (VREF), U2.4 (VREF), U3.4 (VREF), U4.4 (VREF), U5.6 (VBAT), U5.7 (VREF+), U5.8 (VDD), U6.3 (VOUT), U7.4 (VREF), U8.4 (VREF), U9.4 (VREF), U10.4 (VREF), U11.4 (VREF), U13.5 (VCC), U14.5 (VCC), X4.P$5, X5.1, X6.P$5, X7.P$5
+5V: C30.2, D10.1, J2.A4B9 (VBUS1), J2.B4A9 (VBUS2), U12.16 (VCC)
D1: U5.51 (PD1), X1.P$4
GND: C1.2, C2.2, C3.2, C4.2, C5.2, C6.-, C7.2, C8.2, C9.2, C10.2, C11.2, C12.2, C13.2, C14.2, C15.2, C16.2, C17.2, C18.2, C19.2, C20.2, C21.2, C22.2, C23.2, C24.2, C25.2, C26.2, C27.-, C28.2, C29.2, C30.1, C31.1, C32.2, D1.A, D2.2, D3.2, D4.2, D5.2, J2.13 (SHIELD), J2.14 (SHIELD), J2.15 (SHIELD), J2.16 (SHIELD), J2.A1B12 (GND1), J2.B1A12 (GND2), R2.1, R3.1, R9.1, R10.1, TP4.1, U1.1 (GND), U1.7 (ISEN), U1.9 (GND), U2.1 (GND), U2.7 (ISEN), U2.9 (GND), U3.1 (GND), U3.7 (ISEN), U3.9 (GND), U4.1 (GND), U4.7 (ISEN), U4.9 (GND), U5.9 (VSS), U6.1 (GND), U7.1 (GND), U7.7 (ISEN), U7.9 (GND), U8.1 (GND), U8.7 (ISEN), U8.9 (GND), U9.1 (GND), U9.7 (ISEN), U9.9 (GND), U10.1 (GND), U10.7 (ISEN), U10.9 (GND), U11.1 (GND), U11.7 (ISEN), U11.9 (GND), U12.1 (GND), U13.2 (GND), U14.2 (GND), X1.P$1, X3.1, X3.2, X3.3, X3.4, X4.P$3, X5.5, X6.P$3, X7.P$3
I2C1_SCL: R8.1, U5.63 (PB9), U14.4 (A)
I2C1_SCL_0: U14.3 (B0), X4.P$1
I2C1_SCL_1: U14.1 (B1), X6.P$1
I2C1_SDA: R7.1, U5.62 (PB8), U13.4 (A)
I2C1_SDA_0: U13.3 (B0), X4.P$2
I2C1_SDA_1: U13.1 (B1), X6.P$2
I2C1_SEL: U5.64 (PC10), U13.6 (SEL), U14.6 (SEL)
I2C2_SCL: R6.2, U5.33 (PB13), X7.P$1
I2C2_SDA: R5.2, U5.34 (PB14), X7.P$2
M0MAG: C7.1, U5.21 (PA4), X4.P$4
M0U: U2.2 (IN2), U5.42 (PA10)
M0V: U3.2 (IN2), U5.37 (PA9)
M0W: U4.2 (IN2), U5.36 (PA8)
M1MAG: C25.1, U5.22 (PA5), X6.P$4
M1U: U1.2 (IN2), U5.28 (PB1)
M1V: U5.27 (PB0), U7.2 (IN2)
M1W: U5.24 (PA7), U8.2 (IN2)
M2MAG: C26.1, U5.29 (PB2), X7.P$4
M2U: U5.23 (PA6), U9.2 (IN2)
M2V: U5.20 (PA3), U10.2 (IN2)
M2W: U5.19 (PA2), U11.2 (IN2)
unnamed: J2.B5 (CC2), R9.2
unnamed: J2.A5 (CC1), R10.2
unnamed: J1.P$2, U3.6 (OUT1)
unnamed: J1.P$3, U2.6 (OUT1)
unnamed: C31.2, U12.4 (V3)
unnamed: J3.P$3, U1.6 (OUT1)
unnamed: J1.P$1, U4.6 (OUT1)
unnamed: D3.1, R11.1
unnamed: J3.P$2, U7.6 (OUT1)
unnamed: J3.P$1, U8.6 (OUT1)
unnamed: U5.59 (PB5), U9.3 (IN1), U10.3 (IN1), U11.3 (IN1)
unnamed: U1.3 (IN1), U5.58 (PB4), U7.3 (IN1), U8.3 (IN1)
unnamed: J4.P$3, U9.6 (OUT1)
unnamed: U2.3 (IN1), U3.3 (IN1), U4.3 (IN1), U5.57 (PB3)
unnamed: J4.P$2, U10.6 (OUT1)
unnamed: J4.P$1, U11.6 (OUT1)
unnamed: D2.1, R12.1
unnamed: D4.1, R13.1
unnamed: D5.1, R14.1
unnamed: R14.2, U5.13 (PC0)
unnamed: R13.2, U5.14 (PC1)
unnamed: R12.2, U5.15 (PC2)
unnamed: R11.2, U5.16 (PC3)
unnamed: U5.40 (PD8), U12.13 (DTR#)
NRST: C2.1, R1.1, U5.12 (PF2-NRST), X5.4
STM_RX: U5.56 (PD6), U12.2 (TXD)
STM_TX: U5.55 (PD5), U12.3 (RXD)
SWCLK: R2.2, U5.46 (PA14-BOOT0), X5.2
SWDIO: U5.45 (PA13), X5.3
USART1_RX: U5.61 (PB7), X1.P$2
USART1_TX: U5.60 (PB6), X1.P$3
USB_N: J2.A7 (DN1), J2.B7 (DN2), U12.6 (UD-)
USB_P: J2.A6 (DP1), J2.B6 (DP2), U12.5 (UD+)
VCC: C1.1, C3.1, C6.+, C8.1, C9.1, C10.1, C11.1, C12.1, C13.1, C14.1, C15.1, C16.1, C17.1, C18.1, C19.1, C20.1, C21.1, C22.1, C23.1, C24.1, C27.+, D1.C, D10.2, R4.2, U1.5 (VM), U2.5 (VM), U3.5 (VM), U4.5 (VM), U6.2 (VIN), U6.2@1 (VIN), U7.5 (VM), U8.5 (VM), U9.5 (VM), U10.5 (VM), U11.5 (VM), X2.1, X2.2, X2.3, X2.4
VCCMEAS: C28.1, R3.2, R4.1, U5.30 (PB10)

Notes on the sheet:
Programming

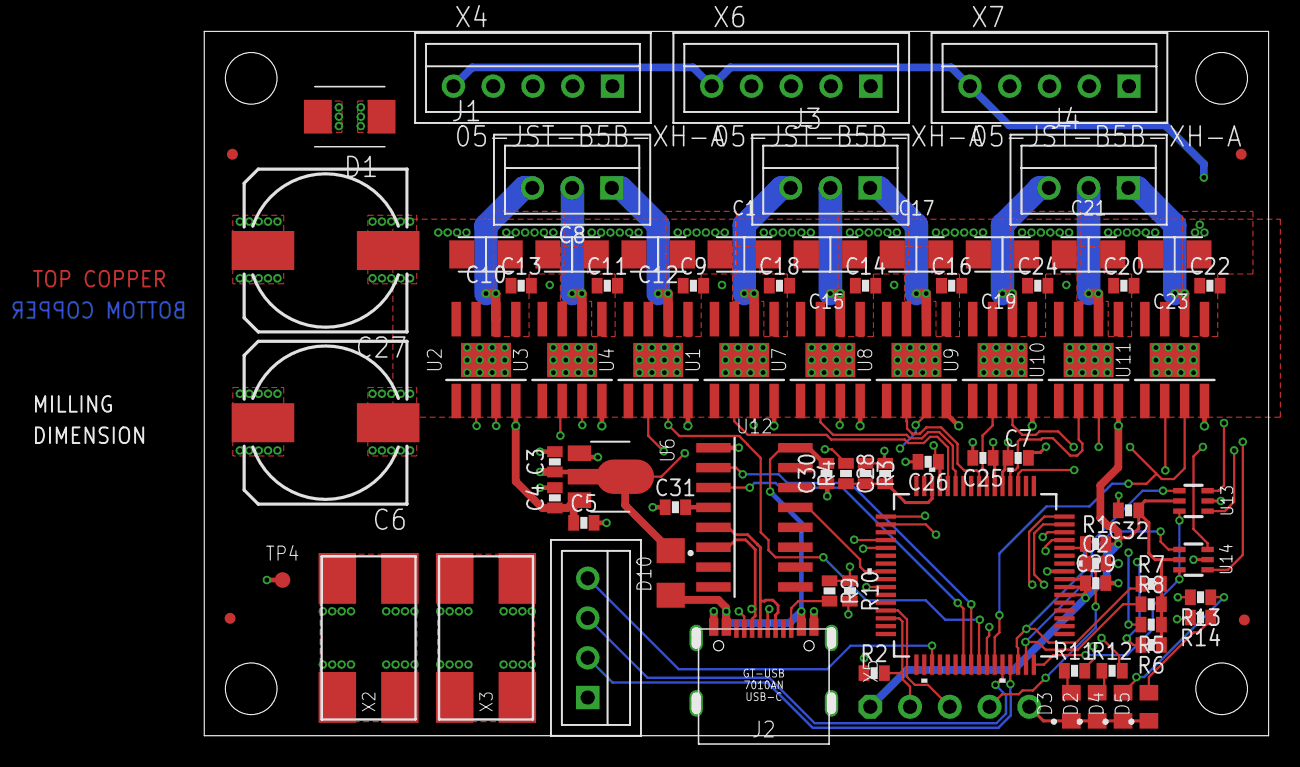
[picture p14: board pcb-bldc-drive-triple.brd from above]

Board: 4 copper layers, 68.0 x 45.0 mm, 84 parts (1 on the bottom side), 60 nets.
