ftobler/bldc-controller/pcb/pcb-bldc-high-current/pcb-bldc-high-current.ioc

Mcu.UserName=STM32G070RBTx
PA10.Signal=S_TIM1_CH3
PA13.Signal=SYS_SWDIO
PA14-BOOT0.Signal=SYS_SWCLK
PA7.Signal=TIM1_CH1N
PA8.Signal=S_TIM1_CH1
PA9.Signal=S_TIM1_CH2
PB0.Signal=TIM1_CH2N
PB1.Signal=TIM1_CH3N
PB6.Signal=USART1_TX
PB7.Signal=USART1_RX
PD5.Signal=USART2_TX
PD6.Signal=USART2_RX
PD8.Signal=USART3_TX
PD9.Signal=USART3_RX
