ftobler/bldc-controller/stm-bldc-drive-triple/Core/Inc/main.h

#define LED1_Pin GPIO_PIN_0
#define LED1_GPIO_Port GPIOC
#define LED2_Pin GPIO_PIN_1
#define LED2_GPIO_Port GPIOC
#define LED3_Pin GPIO_PIN_2
#define LED3_GPIO_Port GPIOC
#define LED4_Pin GPIO_PIN_3
#define LED4_GPIO_Port GPIOC
#define DTR_Pin GPIO_PIN_8
#define DTR_GPIO_Port GPIOD
#define ENABLE_M3_Pin GPIO_PIN_3
#define ENABLE_M3_GPIO_Port GPIOB
#define ENABLE_M2_Pin GPIO_PIN_4
#define ENABLE_M2_GPIO_Port GPIOB
#define ENABLE_M1_Pin GPIO_PIN_5
#define ENABLE_M1_GPIO_Port GPIOB
#define I2C1_SEL_Pin GPIO_PIN_10
#define I2C1_SEL_GPIO_Port GPIOC
