ftobler/bldc-controller/(commit log)

2024-05-10 add dc motor driver
    [dc-motor-driver.brd, dc-motor-driver.sch]
2024-05-10 stm32 project DC controller
2024-05-11 external motor class, oversampling
2024-05-11 position controller, automatic calibration
2024-05-12 working on 3 motors
2024-05-12 fix tasks and startup
    [taskmanager.h]
2024-05-12 start only when all motors are done with calibration
2024-05-12 control loop and improved homing in calibration
2024-05-23 control loop (and calibration) for robot (not working well)
    [motor.cpp, motor.h]
2024-05-25 inverse kinematics and demo
2024-06-11 Sensorless pcb variant 1. Currently abandoned.
    [pcb-bldc-sensorless.brd, pcb-bldc-sensorless.sch]
2024-06-11 pcb sensorless 2 pcb release
    [pcb-bldc-sensorless2.brd, pcb-bldc-sensorless2.sch]
2024-06-11 first version
    [pcb-bldc-high-current.brd, pcb-bldc-high-current.sch]
2024-06-11 2 rs485 drivers
    [pcb-bldc-high-current.brd, pcb-bldc-high-current.sch]
2024-06-11 pcb release high current
    [pcb-bldc-high-current.brd, pcb-bldc-high-current.sch]
