ftobler/bldc-controller/(notices)

Notices in the files:
stm-bldc-drive-triple/Core/Inc/main.h:
Copyright (c) 2024 STMicroelectronics.
All rights reserved.
This software is licensed under terms that can be found in the LICENSE file
parts and their libraries:
stm32: COPYRIGHT: Copyright (C) 2024 Ultra Librarian. All rights reserved.
